DayuDIY/Xuanwu/玄武.jpg

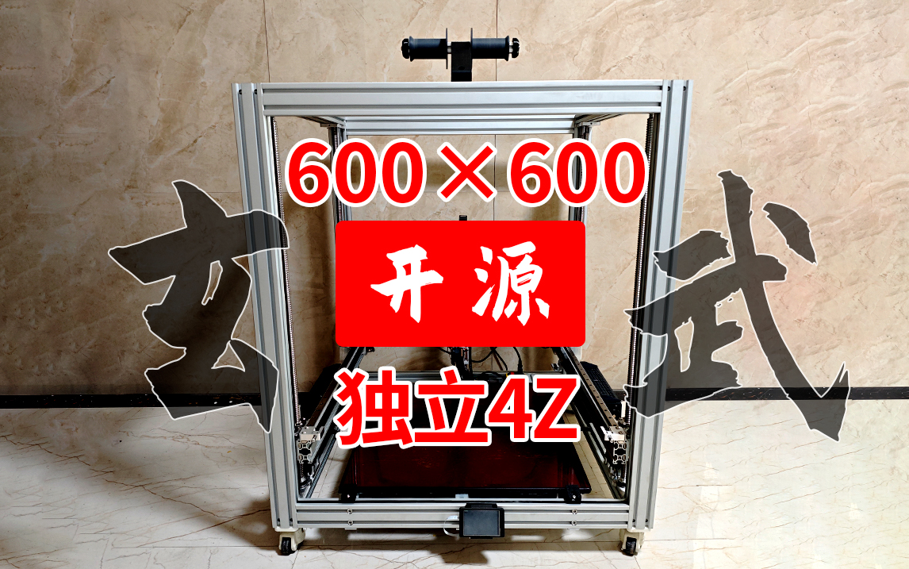
玄武.jpg
