DayuDIY/Xuanwu/README.md

# Xuanwu
来自中国的大鱼DIY开源的大型3D打印机项目，
你可以在哔哩哔哩上关注我，
以获取最新的资料及视频教程。
在哔哩哔哩上有该3D打印机的相关视频，
网址是：https://www.bilibili.com/video/BV1c6rmYjEGh/
该项目内容禁止商用！
