DayuDIY/Xuanwu/玄武_铝合金CNC零件/所有CNC零件.png

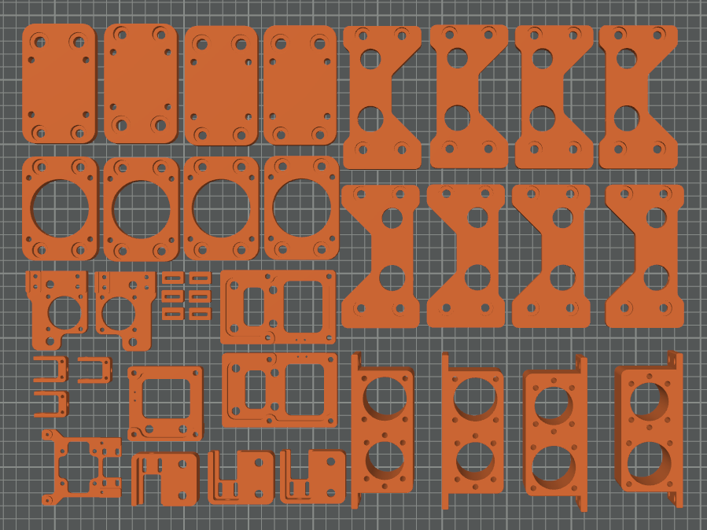
玄武_铝合金CNC零件/所有CNC零件.png
