DayuDIY/Xuanwu/B站【大鱼DIY】3D打印机_玄武 V1.0采购清单.xlsx

Sheet: 玄武1.0配件清单
【B站UP主：大鱼DIY】3D打印机_玄武 V1.0采购清单 以下所有链接本人未获取任何好处，若商家修改链接内容本人不承担任何后果，所有东西均可在淘宝找同规格产品，自己选择。
郑重声明 |  |  | 个别奸商篡改清单内容发到其他渠道，高价出售零部件的行为当真缺德，一经发现必定曝光！
视频教程 |  |  | https://www.bilibili.com/video/BV1c6rmYjEGh/
行程范围：600mm×600mm×600mm
序号 |  | 名称 | 规格 | 数量 | 单价 | 折扣/运费 | 总价 | 链接 | 备注
1 | Klipper 电气系统 FLY家的报我名字打9折 | 上位机+屏幕 | 套餐2 Fly Pi+3.5寸屏 | 1 | 199 | 0.9 | 179.1 | https://item.taobao.com/item.htm?_u=i208d75petd305&id=676114118467&skuId=5033614603650
 |  | 下位机 | SUPER 8 PRO | 1 | 288 | 0.9 | 259.2 | https://item.taobao.com/item.htm?spm=a1z10.5-c-s.w4002-23066022675.17.7d8a3903FVNXCO&id=677120565255
 |  | 大驱动 | TMC5160 Pro | 7 | 79 | 0.9 | 497.7 | https://item.taobao.com/item.htm?id=673666493168&skuId=5329371279692
 |  | 小驱动 | 2209 | 1 | 23 | 0.9 | 20.7 | https://item.taobao.com/item.htm?id=637412178454&skuId=5330446627699
 |  | 无线网卡 | 150M单频 迷你便携 | 1 | 19.8 | 0 | 19.8 | https://detail.tmall.com/item.htm?_u=i208d75petfee9&id=650379489910&spm=a1z09.2.0.0.4db42e8dCEay8S
 |  |  |  |  |  | 小计 | 976.5
2 | 非标结构件 | 非标CNC结构件 不含挤出机 |  | 1 | 1058 | 10 | 1068 | https://item.taobao.com/item.htm?id=872197698068&spm=a21xtw.29178619.product_shelf.1.30316a3cvkQzgr
 |  | klicky调平 |  | 1 | 20 | 10 | 30
 | 工具头 | 双丝进料工具头 含挤出机+热端+鸣志电机 | 报我名字有折扣 | 1 | 700 | 0.9 | 630 | https://item.taobao.com/item.htm?id=872770468601&spm=a213gs.v2success.0.0.1cd14831dNM7qx
 |  |  |  |  |  | 小计 | 1728
3 | 铝型材 两个链接，一个是嘉立创的，一个是淘宝的，选一个即可 | 欧标3060+3030铝型材 总共18根 | 参照图纸加工 图纸发送给卖家即可 | 1 | 700 | 60 | 760 | https://www.jlcfa.com/serial/1165480689116.html?codeModel=TXLF-308-W&productModel=TXLF-308-W
 |  |  |  | 两个价格一样，自由选择 |  |  |  | https://item.taobao.com/item.htm?id=557406833178&skuId=5706890393991
 | 选配型材 | 欧标2020铝型材 330mm长 用于安装料架，非必要 | 两头中心孔攻丝M6，共1根 | 1 | 8 | 0 | 8
 |  |  |  |  |  | 小计 | 768
4 | 线轨 | 线轨 报我名字打9折 | 670mm长轨道+ MGN15H滑块 | 3 | 81 | 0 | 243 | https://item.taobao.com/item.htm?id=538777574566&spm=2015.23436601.0.0&qq-pf-to=pcqq.c2c
 |  |  |  |  |  | 小计 | 243
5 | 光轴 | 光轴 | 硬轴直径20mm 858mm长 | 4 | 26.5 | 0 | 106 | https://item.taobao.com/item.htm?_u=t208d75pet2cd6&id=586921043351&sku_properties=122276018%3A20213
 | 法兰直线轴承 | 方型法兰轴承 | LMK20UU LMK20×32×42 | 4 | 8.5 | 0 | 34
 |  |  |  |  |  | 小计 | 140
6 | 滚珠丝杆 | 按图加工 858mm长4根 | 1605丝杆+螺母 | 4 | 95 | 0 | 380 | https://item.taobao.com/item.htm?_u=t208d75pet3a03&id=714103839586&spm=a1z09.2.0.0.3c722e8dJf2jAr
 |  |  |  |  |  | 小计 | 380
7 | 弹簧 | 用于XYZ三轴调节同步带松紧 | 线径1外径8长20 | 1 | 5 | 0 | 5 | https://detail.tmall.com/item.htm?_u=t208d75petf549&id=575363698316&spm=a1z09.2.0.0.3c722e8dJf2jAr
 |  | 用于压紧滚珠丝杆 | 线径1.4外径11长30 | 1 | 8 | 0 | 8
8 | 钢化玻璃 | 透明的便宜一点，55包邮 茶色及黑色贵一点 | 600mm*630mm 厚度8mm | 1 | 55 | 0 | 55 | https://detail.tmall.com/item.htm?_u=t208d75petad27&id=605517219162&spm=a1z09.2.0.0.3c722e8dJf2jAr
9 | T型硅胶条 | 卡在铝型材里面 作为热床的隔热和缓冲 | TP34 | 2 | 7 | 0 | 14 | https://detail.tmall.com/item.htm?_u=t208d75petcb68&id=733876404468&spm=a1z09.2.0.0.3c722e8dJf2jAr
10 | 硅胶热床 | 按图纸定制 出线放在距离边缘200mm处 | 600*600 | 1 | 180 | -20 | 160 | https://detail.tmall.com/item.htm?_u=t208d75pet4ef8&id=624594518317&spm=a1z09.2.0.0.3c722e8dJf2jAr
11 | 保温棉 | 自己裁剪 贴在硅胶加热垫下面 | 带背胶10mm厚1平米 | 1 | 4.3 | 0 | 4.3 | https://detail.tmall.com/item.htm?_u=t208d75pet43e7&id=694013872425&spm=a1z09.2.0.0.3c722e8dJf2jAr
12 | 福马轮 |  | 福马轮40F | 4 | 10 | 0 | 40 | https://item.taobao.com/item.htm?_u=t208d75petdd6a&id=614622055158&spm=a1z09.2.0.0.3c722e8dJf2jAr
 |  |  |  |  |  | 小计 | 286.3
13 | 【同志】3D打印机配件包 |  | 详见本表第二页 | 1 | 479.47 | -49.47 | 430 | https://item.taobao.com/item.htm?id=873787432434&spm=a213gs.v2success.0.0.259948315EvLyy
 |  |  |  |  |  | 小计 | 430
14 | 螺钉 螺母 | 单头铜柱 | M3×20+6 | 2 | 0.6 | 0 | 1.2 | https://detail.tmall.com/item.htm?id=541776094503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
15 |  | 内六角平圆头螺钉 | M3×6 | 30 | 0.03 | 0 | 0.9
16 |  |  | M3×12 | 56 | 0.04 | 0 | 2.24 | https://detail.tmall.com/item.htm?id=637014599330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
17
18 |  |  | M3×22 | 10 | 0.08 | 0 | 0.8
19 |  |  | M3×25 | 2 | 0.09 | 0 | 0.18
20 |  |  | M4×8 | 12 | 0.05 | 0 | 0.6
21 |  |  | M6×12 | 124 | 0.16 | 0 | 19.84
22 |  |  | M6×20 | 3 | 0.18 | 0 | 0.54
23 |  |  | M8×16 | 28 | 0.22 | 0 | 6.16
24 |  | 内六角圆柱头螺钉 | M2×10 | 18 | 0.03 | 0 | 0.54 | https://detail.tmall.com/item.htm?_u=4208d75pet5977&id=601878243485&skuId=5535412599027
25 |  |  | M3×8 | 50 | 0.03 | 0 | 1.5
26 |  |  | M5×16 | 40 | 0.14 | 0 | 5.6
27 |  |  | M5×30 | 15 | 0.2 | 0 | 3
28 |  |  | M5×35 | 16 | 0.22 | 0 | 3.52
29 |  |  | M8×35 | 12 | 0.65 | 0 | 7.8
30 |  |  | M8×65 | 16 | 0.94 | 0 | 15.04
31 |  | 垫片 | 8×12×1 | 8 | 0.07 | 0 | 0.56 | https://detail.tmall.com/item.htm?abbucket=16&id=601878075662
32 |  |  | 5×12×1 | 3 | 0.05 | 0 | 0.15
33 |  | T型螺母 | 20型M3 仅用于固定料架 | 2 | 0.1 | 0 | 0.2 | https://item.taobao.com/item.htm?_u=4208d75petb3ab&id=15146235453&spm=a1z09.2.0.0.4e072e8dACxZCR
34 |  |  | 30型M3×15.5×8 | 64 | 0.1 | 0 | 6.4
35 |  | 滑块螺母，需要提前放入型材 用T型螺母更省事，不用提前放好 | 30型M6-A | 124 | 0.1 | 0 | 12.4 | https://item.taobao.com/item.htm?_u=4208d75petdcd7&id=41966325030&skuId=5098531407012
36 |  | 弹形扣件 | 欧标3030（50个） 只需要16个 | 1 | 7.8 | 0 | 7.8 | https://detail.tmall.com/item.htm?_u=4208d75petacd2&id=710086294864&spm=a1z09.2.0.0.28112e8dzYkcnE
37 |  | 外螺纹圆柱销 | M5×20（5个） 需要7个 | 2 | 2.68 | 0 | 5.36 | https://detail.tmall.com/item.htm?_u=4208d75petdc6b&id=616664551961&spm=a1z09.2.0.0.28112e8dzYkcnE
39 |  | 热熔螺母 | M2×4×3.5 | 14 | 0.07 | 0 | 0.98 | https://detail.tmall.com/item.htm?_u=4208d75pet5769&id=691362839974&spm=a1z09.2.0.0.4e072e8dACxZCR
40 |  |  | M3×4×4.2 | 8 | 0.08 | 0 | 0.64
 |  |  |  |  |  | 小计 | 103.95
41 | 供电系统 | 明纬开关电源 | LRS-350-24 24V14.6A | 3 | 106 | 0 | 318 | https://item.taobao.com/item.htm?_u=i208d75pet6955&id=570951343107&spm=a1z09.2.0.0.4db42e8dCEay8S
42 |  | 电源插座 | 螺丝固定式-上下耳-大红开-带线 | 1 | 7.2 | 0 | 7.2 | https://detail.tmall.com/item.htm?_u=4208d75pet4cf3&id=795022264448&spm=a1z09.2.0.0.35282e8dAyc3v2
 |  |  |  |  |  | 小计 | 325.2
43 | 其他配件 | 横流风机 辅助散热用 | 40250D 24V | 2 | 75.8 | 0 | 151.6 | https://item.taobao.com/item.htm?_u=t208d75petecd3&id=524874916615&spm=a1z09.2.0.0.3c722e8dJf2jAr
44 |  | 一字连接板 | 3030型2孔 | 6 | 1.3 | 4 | 11.8 | https://item.taobao.com/item.htm?_u=t208d75peta1ec&id=533716881777&spm=a1z09.2.0.0.3c722e8dJf2jAr
 |  |  |  |  |  | 小计 | 163.4
 | 其他材料 | ① 1平方的线若干，用于品字开关分三路接开关电源的零线、火线和地线，以及开关电源的24V输出到主板和驱动，需要3个颜色，每个颜色约5米； ② 2平方的线若干，用于交流热床的供电； ③ 0.5平方的红黑双色线若干，用于延长加热棒的接线，每个颜色约4米； ④ 0.2平方的线若干，用于加长各种各样的线； ⑤ 热缩管若干，用于线路接头处的绝缘； ⑥ 缠绕管若干，用于收纳线束。
 |  |  |  |  |  | 合计: | 5544.35 | 如有遗漏或错误，麻烦您联系我更正，谢谢（不提供技术支持）！ QQ：88910246

Sheet: 【同志】3D打印机配件清单
序号 | 名称 | 规格 | 数量 | 单价 | 运费 | 小计 | 链接 | 货号
1 | 57步进电机 XYZ轴用 | 56高 1个3米长的线 2个2米长的线 | 3 | 56 | 0 | 168 | https://item.taobao.com/item.htm?id=796381580261&skuId=5432413033655
2 |  | 45高 1米线 | 4 | 46 | 0 | 184
3 | 同步轮 | 20齿内孔8带宽10 | 7 | 1.66 | 0 | 11.62 | https://item.taobao.com/item.htm?spm=a21dvs.23580594.0.0.1d293d0dSrcL9j&ft=t&id=559194333476
4 |  | 40齿内孔8带宽10 | 4 | 3.8 | 0 | 15.2
5 | 惰轮 | 20齿内孔5 带宽10带齿 | 3 | 1 | 0 | 3 | https://item.taobao.com/item.htm?id=559682437946&skuId=3872290557040
6 | 闭环同步带 | 带宽10mm周长220mm | 4 | 2.3 | 0 | 9.2 | https://item.taobao.com/item.htm?id=652223908476&spm=a1z10.3-c-s.w4002-17331600343.19.36f33e69KNJAi3
7 | 同步带 | GT2-10mm 10米/条 | 1 | 33.7 | 0 | 33.7 | https://item.taobao.com/item.htm?id=660458877911&skuId=4935925462805
8 | 限位开关 只接两根线 | 需要常闭，线长2米 | 3 | 1.3 | 0 | 3.9 | https://item.taobao.com/item.htm?spm=a21dvs.23580594.0.0.1d293d0dPgRrtF&ft=t&id=560056223373
9 | 铁氟龙管 引导线束用，非必要 | 乳白色2*4，1.75耗材 | 1 | 3.5 | 0 | 3.5 | https://item.taobao.com/item.htm?spm=a21dvs.23580594.0.0.1d293d0dPgRrtF&ft=t&id=659862681620
10 | 3010风扇 | 24V | 1 | 3 | 0 | 3 | https://item.taobao.com/item.htm?spm=a21dvs.23580594.0.0.1d293d0doZMbnz&ft=t&id=560285123186
11 | 4020鼓风风扇 | 24V两线 XH2.54 | 1 | 4.1 | 0 | 4.1 | https://item.taobao.com/item.htm?spm=a21dvs.23580594.0.0.1d293d0dPgRrtF&ft=t&id=560037644826
12 | 4010风扇 驱动散热 | 4010风扇12V | 7 | 1.85 | 0 | 12.95 | https://item.taobao.com/item.htm?id=559773126423&skuId=5097069995514
13 | 电源线 |  | 1 | 4.5 | 0 | 4.5 | https://item.taobao.com/item.htm?spm=a1z10.5-c-s.w4002-22254585059.16.16b33708kxrQvS&id=546606733627
14 | 法兰轴承 | F688ZZ（8*18*5） | 8 | 0.75 | 0 | 6 | https://item.taobao.com/item.htm?id=559716049401
15 | 隔离柱 | 5*10*15 | 12 | 0.6 | 0 | 7.2 | https://item.taobao.com/item.htm?id=620496119636
16 |  | 5*10*20 | 16 | 0.6 | 0 | 9.6
 |  |  |  |  | 合计 | 479.47
