DayuDIY/Xuanwu/玄武_3D打印零件/4020风道.3mf

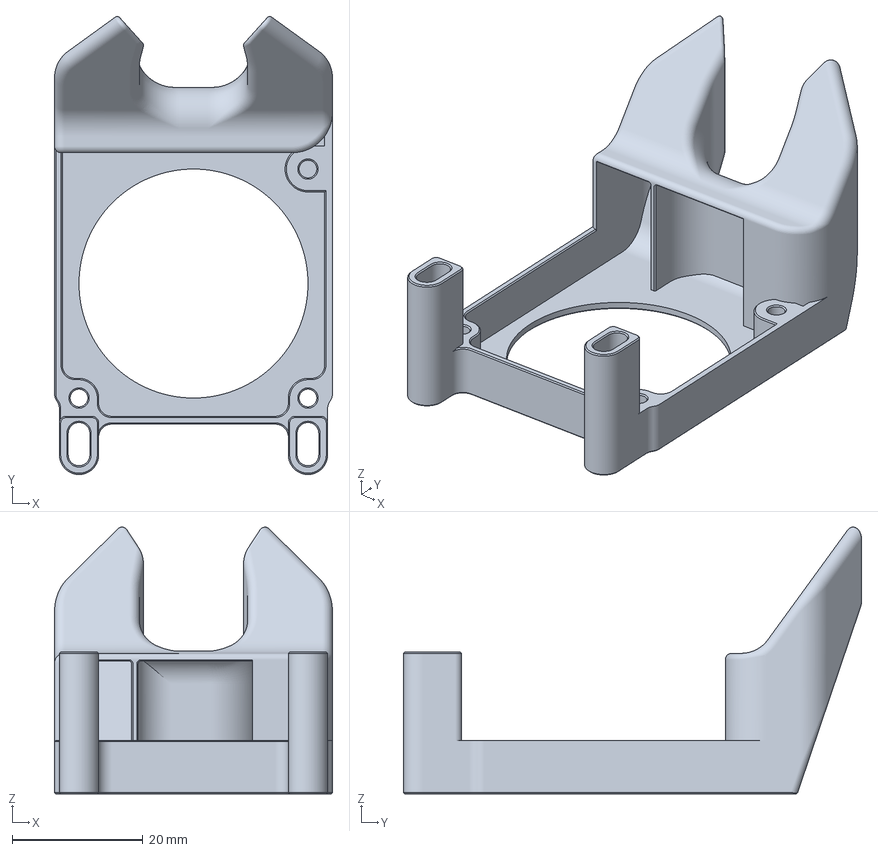
[picture p3: CAD file, 2025-01-11]
玄武_3D打印零件/4020风道.3mf
42.5 x 70.0 x 40.8 mm
