DayuDIY/Xuanwu/玄武_3D打印零件/可自行打印零件/料架组件_适用于常见的1~3公斤耗材/料架_玄武.STEP

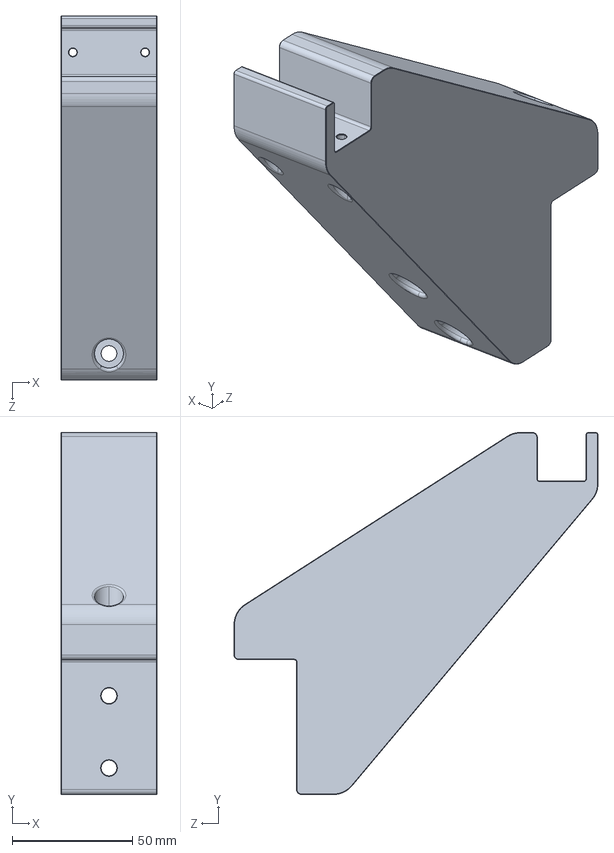
[picture p4: CAD file, 2025-01-11]
玄武_3D打印零件/可自行打印零件/料架组件_适用于常见的1~3公斤耗材/料架_玄武.STEP
40.0 x 150.4 x 151.2 mm
