DayuDIY/Xuanwu/玄武_3D打印零件/可自行打印零件/电气仓零件/屏幕组件_FLY TFT/屏幕盖子_FLY TFT V2.STEP

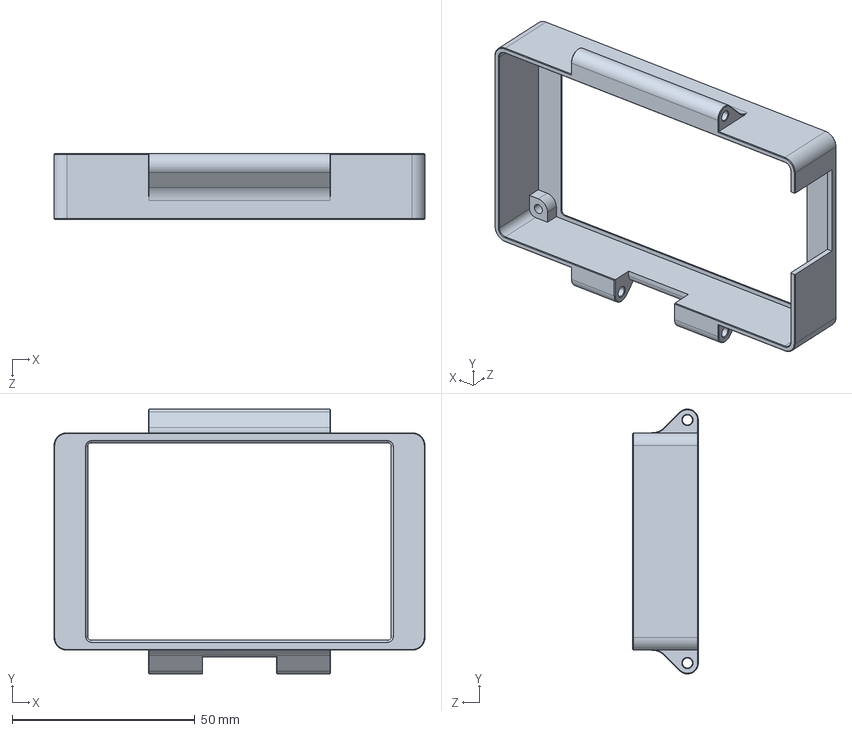
[picture p5: CAD file, 2025-01-11]
玄武_3D打印零件/可自行打印零件/电气仓零件/屏幕组件_FLY TFT/屏幕盖子_FLY TFT V2.STEP
101.5 x 72.5 x 18.0 mm
