DayuDIY/Xuanwu/玄武_3D打印零件/可自行打印零件/辅助风扇组件_2套/40贯流风扇防护网.STEP

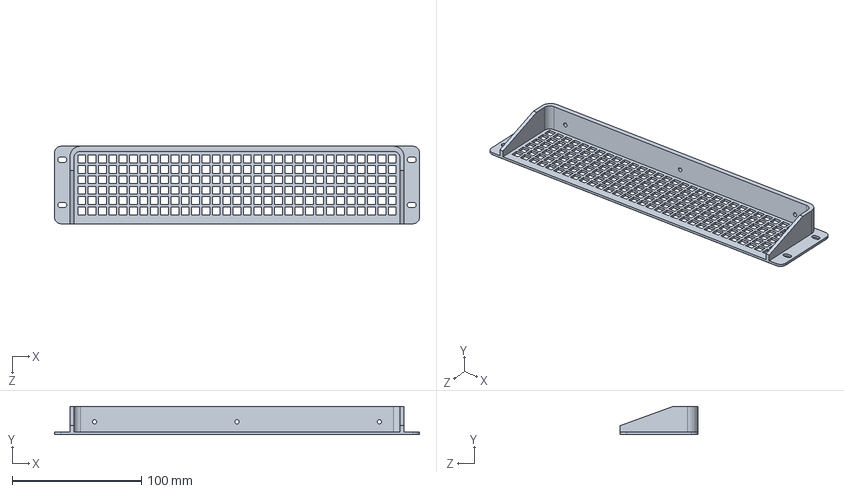
[picture p7: CAD file, 2025-01-11]
玄武_3D打印零件/可自行打印零件/辅助风扇组件_2套/40贯流风扇防护网.STEP
282.0 x 22.0 x 60.0 mm
