DayuDIY/Xuanwu/玄武_3D打印零件/装机必备打印件/Klicky组件/klicky安装座.STEP

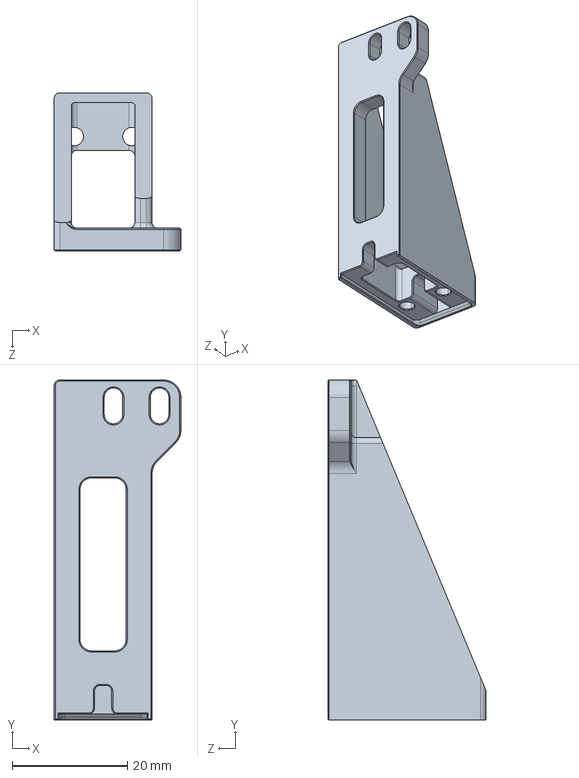
[picture p8: CAD file, 2025-01-11]
玄武_3D打印零件/装机必备打印件/Klicky组件/klicky安装座.STEP
22.0 x 59.0 x 27.5 mm
