DayuDIY/Xuanwu/玄武_铝合金CNC零件/STP格式/57步进电机支架_Z轴_4件.STEP

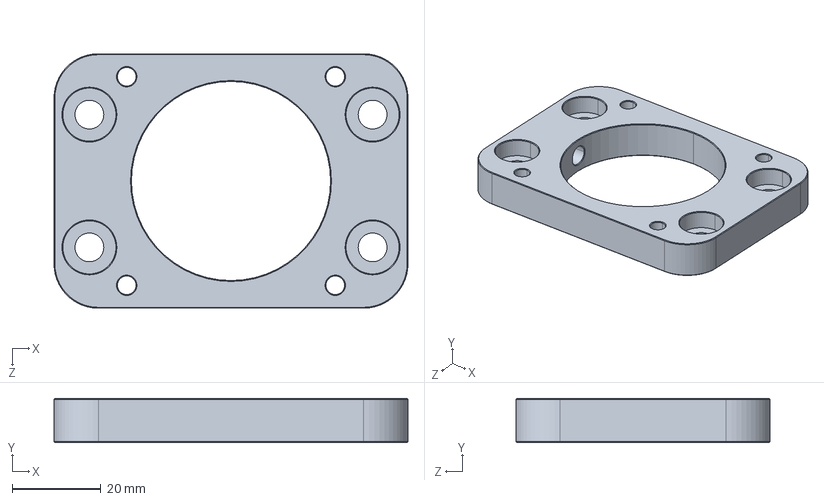
[picture p9: CAD file, 2025-01-11]
玄武_铝合金CNC零件/STP格式/57步进电机支架_Z轴_4件.STEP
80.0 x 10.0 x 57.5 mm
