DayuDIY/Xuanwu/玄武_3D打印零件/可自行打印零件/料架组件_适用于常见的1~3公斤耗材/滚筒堵头_2件.STEP

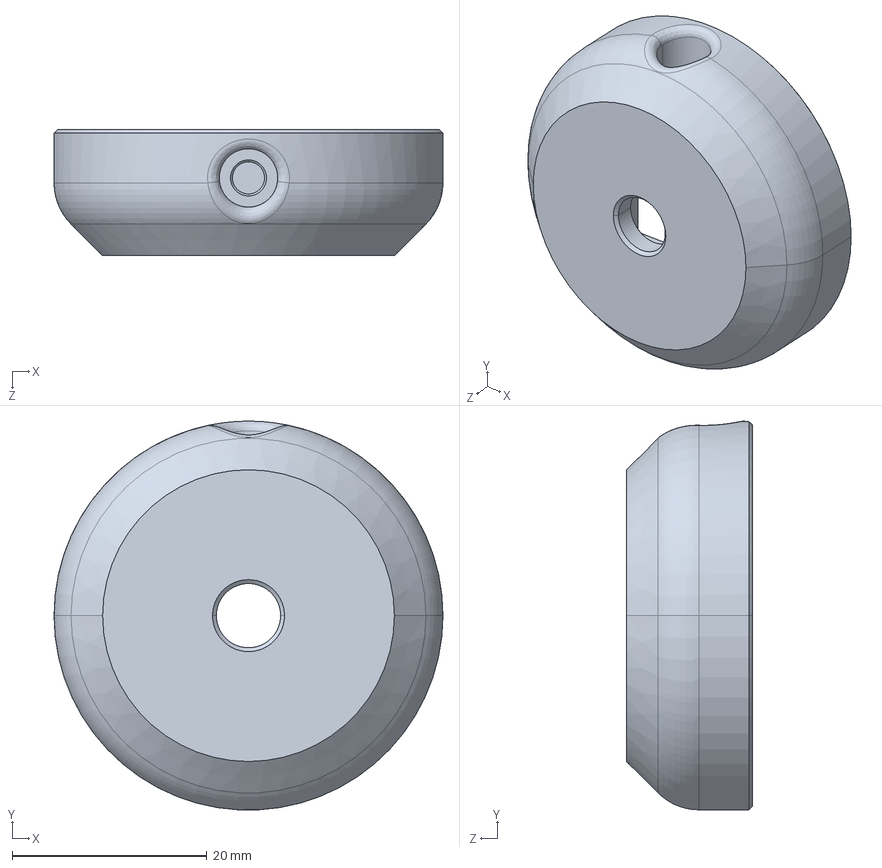
[picture p10: CAD file, 2025-01-11]
玄武_3D打印零件/可自行打印零件/料架组件_适用于常见的1~3公斤耗材/滚筒堵头_2件.STEP
40.0 x 40.0 x 13.0 mm
