DayuDIY/Xuanwu/玄武_3D打印零件/可自行打印零件/电气仓零件/屏幕组件_FLY TFT/调节臂.STEP

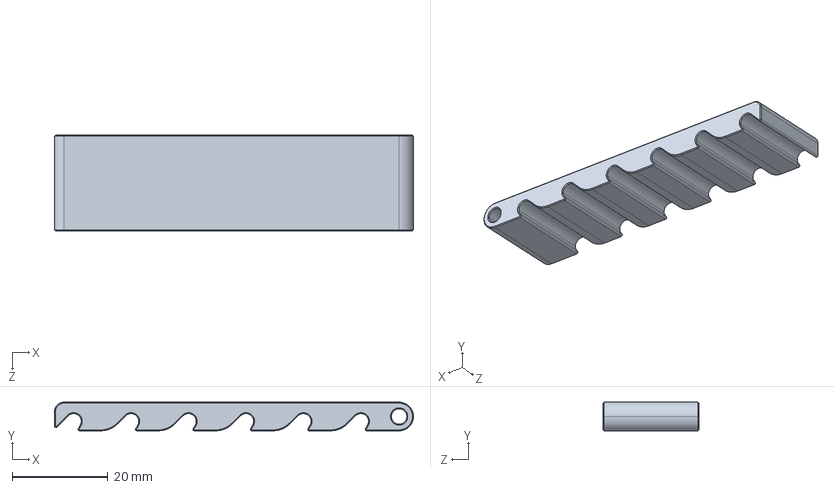
[picture p11: CAD file, 2025-01-11]
玄武_3D打印零件/可自行打印零件/电气仓零件/屏幕组件_FLY TFT/调节臂.STEP
75.0 x 6.00 x 20.0 mm
