DayuDIY/Xuanwu/玄武_3D打印零件/可自行打印零件/电气仓零件/电源锁紧卡扣.STEP

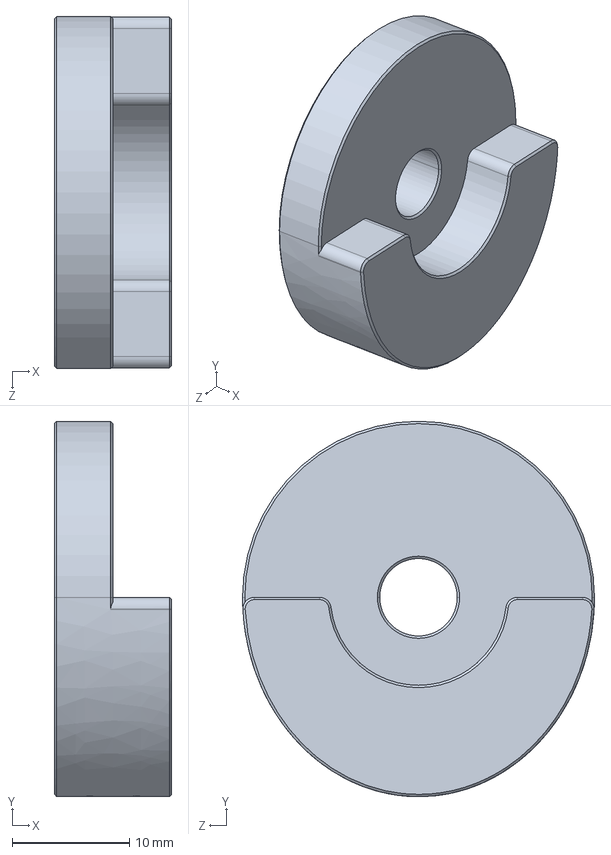
[picture p12: CAD file, 2025-01-11]
玄武_3D打印零件/可自行打印零件/电气仓零件/电源锁紧卡扣.STEP
10.0 x 32.0 x 30.0 mm
