DayuDIY/Xuanwu/玄武_3D打印零件/可自行打印零件/辅助风扇组件_2套/40贯流风扇安装支架.STEP

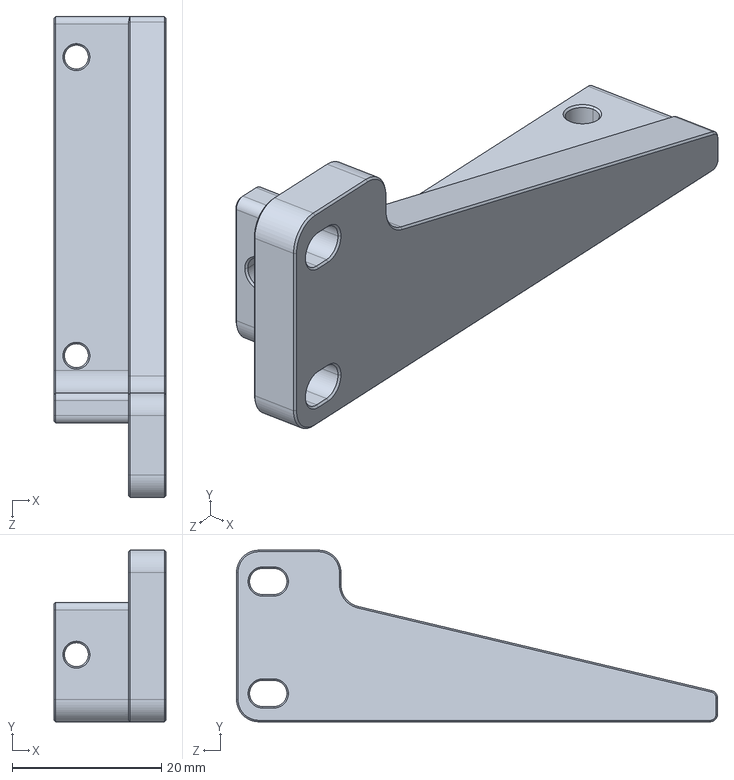
[picture p13: CAD file, 2025-01-11]
玄武_3D打印零件/可自行打印零件/辅助风扇组件_2套/40贯流风扇安装支架.STEP
15.0 x 23.0 x 64.4 mm
