DayuDIY/Xuanwu/玄武_3D打印零件/装机必备打印件/Klicky组件/klicky停靠坞.STEP

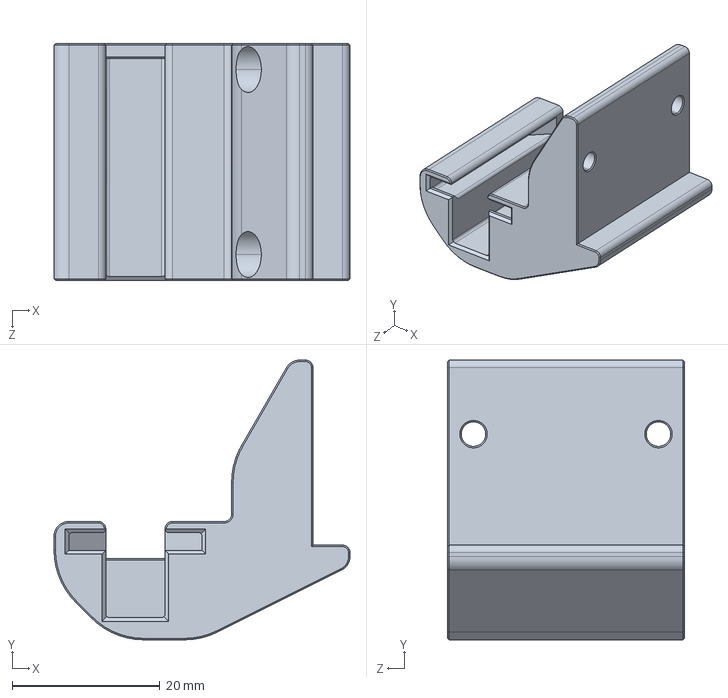
[picture p14: CAD file, 2025-01-11]
玄武_3D打印零件/装机必备打印件/Klicky组件/klicky停靠坞.STEP
40.0 x 37.8 x 32.0 mm
