DayuDIY/Xuanwu/玄武_3D打印零件/装机必备打印件/喉管风扇支架.STEP

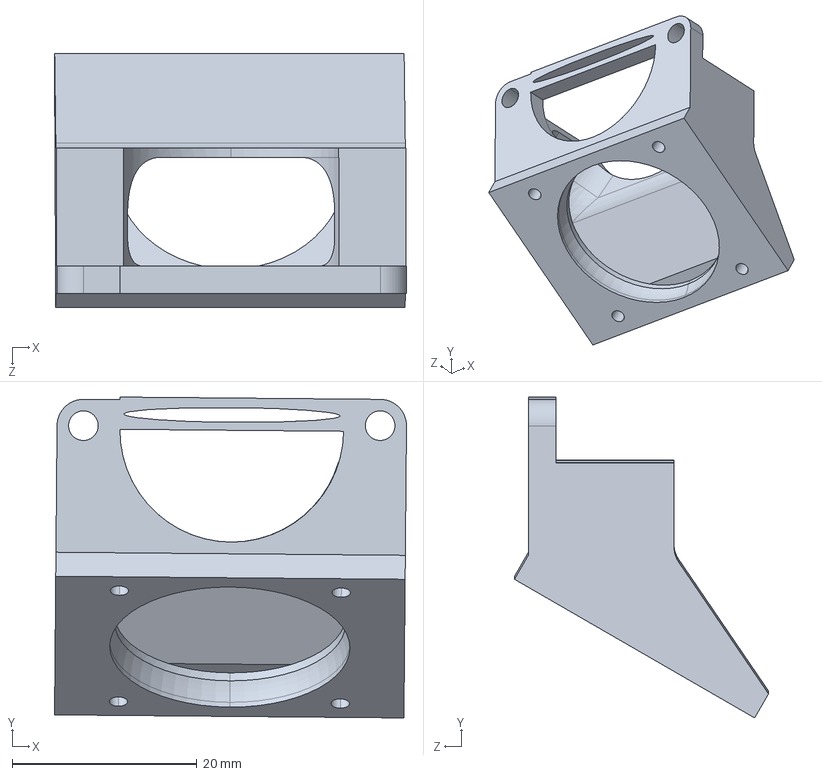
[picture p15: CAD file, 2025-01-11]
玄武_3D打印零件/装机必备打印件/喉管风扇支架.STEP
38.1 x 34.7 x 27.5 mm
