DayuDIY/Xuanwu/玄武_铝合金CNC零件/STP格式/X轴转接件_双进丝.STEP

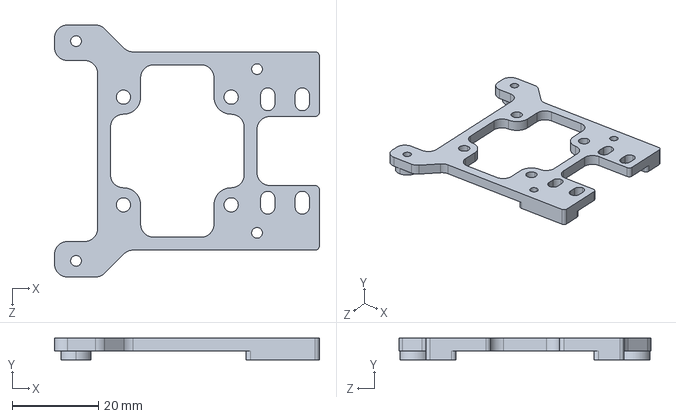
[picture p16: CAD file, 2025-01-11]
玄武_铝合金CNC零件/STP格式/X轴转接件_双进丝.STEP
61.5 x 5.00 x 58.5 mm
