DayuDIY/Xuanwu/玄武_3D打印零件/可自行打印零件/料架组件_适用于常见的1~3公斤耗材/耗材滚筒_2件.STEP

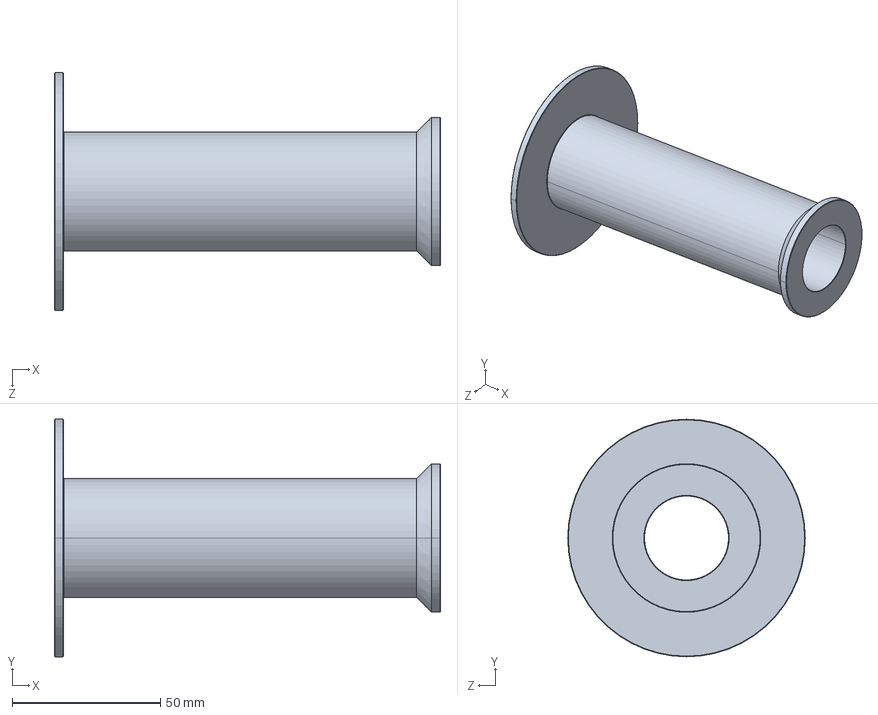
[picture p17: CAD file, 2025-01-11]
玄武_3D打印零件/可自行打印零件/料架组件_适用于常见的1~3公斤耗材/耗材滚筒_2件.STEP
130.0 x 80.0 x 80.0 mm
