DayuDIY/Xuanwu/玄武_3D打印零件/可自行打印零件/电气仓零件/屏幕组件_FLY TFT/屏幕底板.STEP

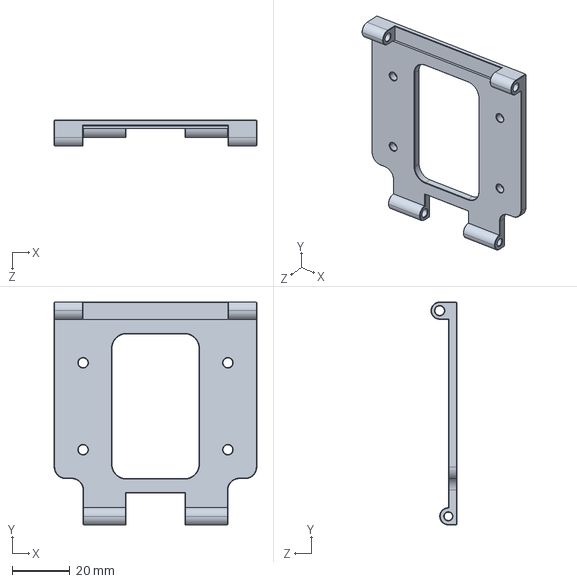
[picture p18: CAD file, 2025-01-11]
玄武_3D打印零件/可自行打印零件/电气仓零件/屏幕组件_FLY TFT/屏幕底板.STEP
70.0 x 77.0 x 9.00 mm
