DayuDIY/Xuanwu/玄武_3D打印零件/可自行打印零件/电气仓零件/电气仓底板_FLY V1.1.STEP

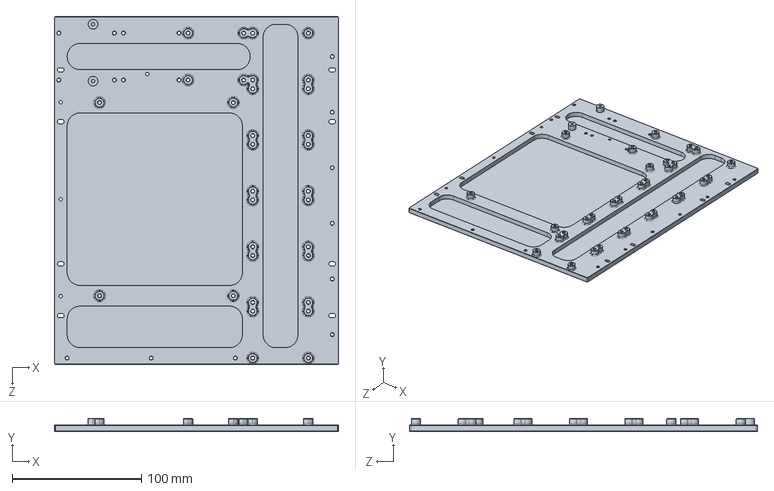
[picture p19: CAD file, 2025-01-11]
玄武_3D打印零件/可自行打印零件/电气仓零件/电气仓底板_FLY V1.1.STEP
220.0 x 10.0 x 269.2 mm
