DayuDIY/Xuanwu/玄武_3D打印零件/可自行打印零件/辅助风扇组件_2套/40贯流风扇风道.STEP

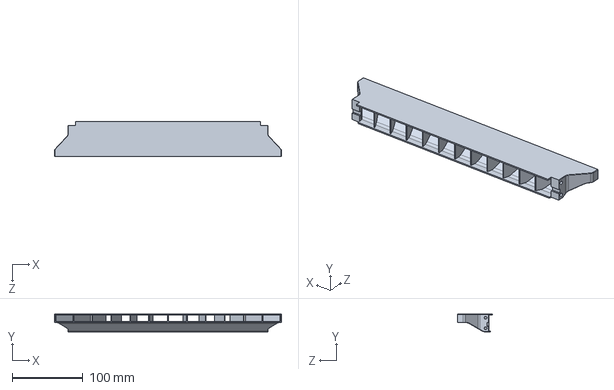
[picture p20: CAD file, 2025-01-11]
玄武_3D打印零件/可自行打印零件/辅助风扇组件_2套/40贯流风扇风道.STEP
320.0 x 25.0 x 50.0 mm
