DayuDIY/Xuanwu/玄武_3D打印零件/装机必备打印件/热床压紧块_4件.STEP

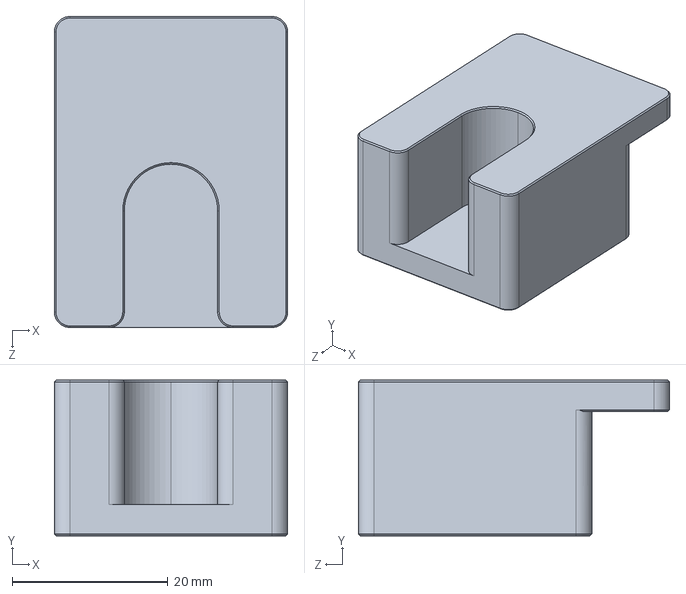
[picture p21: CAD file, 2025-01-11]
玄武_3D打印零件/装机必备打印件/热床压紧块_4件.STEP
30.0 x 20.0 x 40.0 mm
