DayuDIY/Xuanwu/玄武_铝合金CNC零件/STP格式/直线轴承座_上_2件.STEP

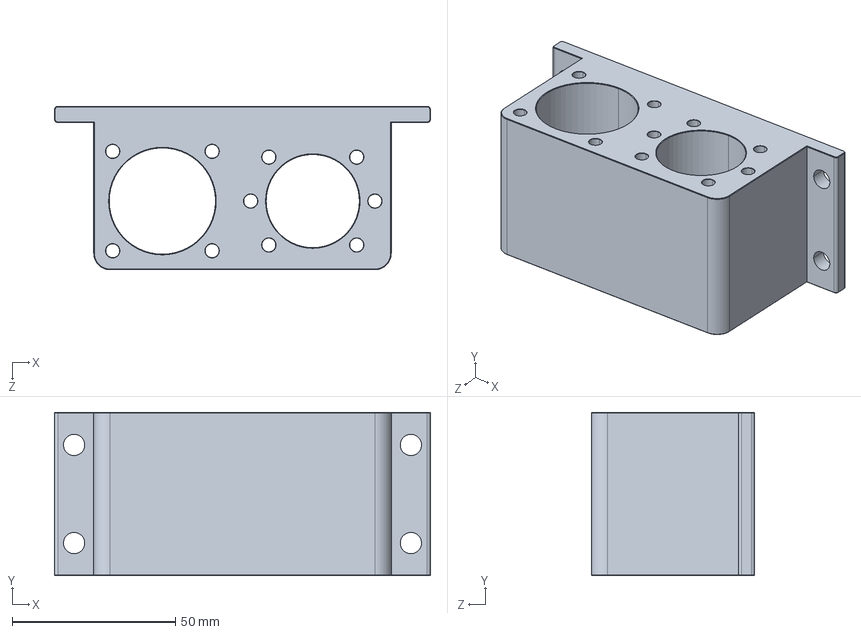
[picture p22: CAD file, 2025-01-11]
玄武_铝合金CNC零件/STP格式/直线轴承座_上_2件.STEP
115.0 x 50.0 x 50.0 mm
