DayuDIY/Xuanwu/玄武_3D打印零件/可自行打印零件/料架组件_适用于常见的1~3公斤耗材/顶置料架_装配图.STEP

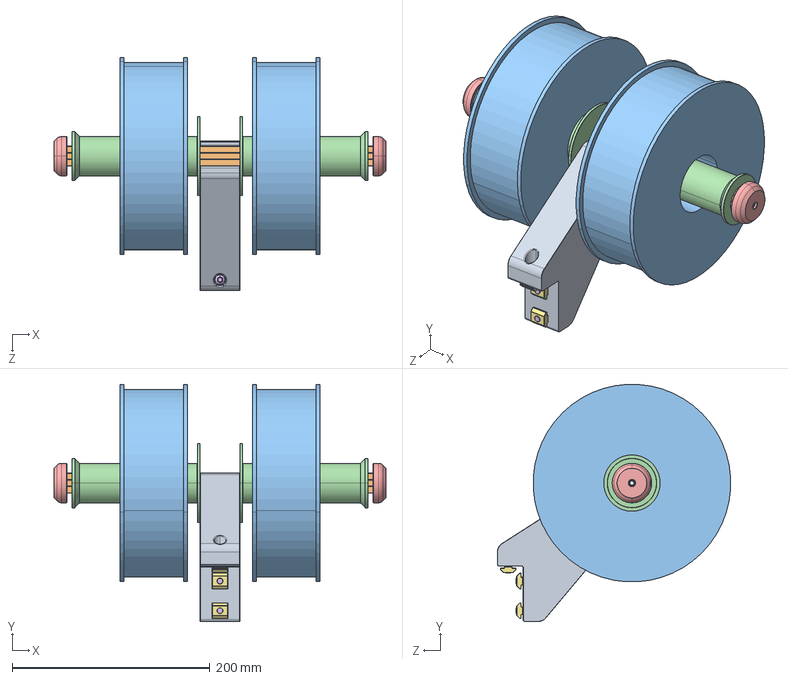
[picture p23: CAD file, 2025-01-11]
玄武_3D打印零件/可自行打印零件/料架组件_适用于常见的1~3公斤耗材/顶置料架_装配图.STEP
336.0 x 240.0 x 236.0 mm
料架_玄武
铝型材2020料架
耗材 x 2
耗材滚筒 x 2
滚筒堵头 x 2
内六角平圆头螺钉M6×12 x 3
滑块螺母_欧标30型M6_A x 3
