DayuDIY/Xuanwu/玄武_3D打印零件/可自行打印零件/电气仓零件/电源连接件.STEP

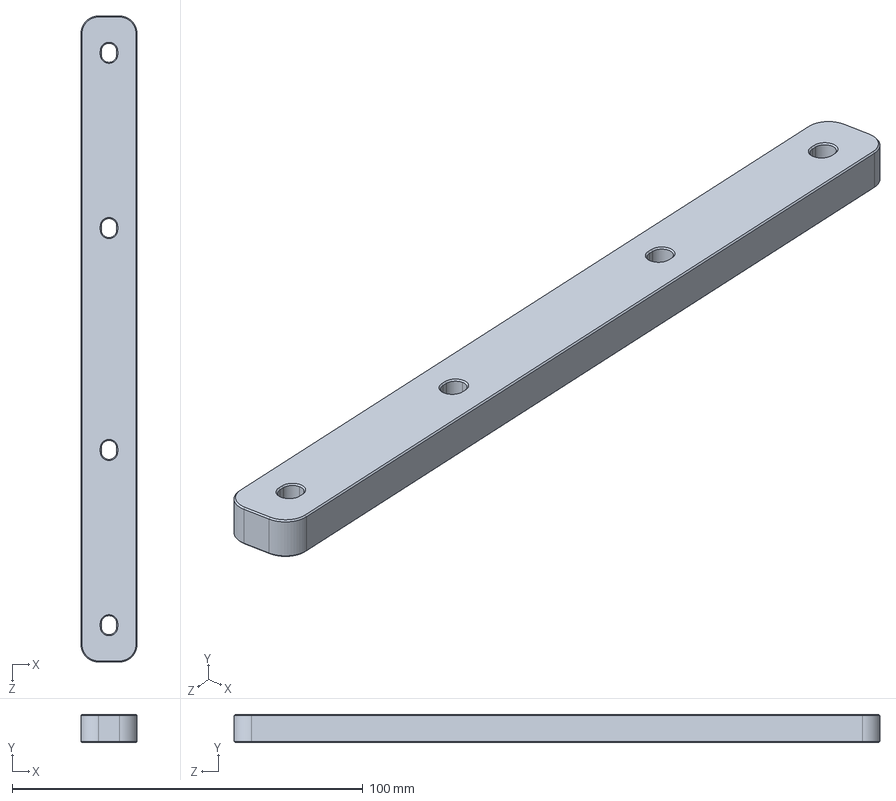
[picture p24: CAD file, 2025-01-11]
玄武_3D打印零件/可自行打印零件/电气仓零件/电源连接件.STEP
16.0 x 8.00 x 184.3 mm
