DayuDIY/Xuanwu/玄武_铝合金CNC零件/STP格式/同步带卡扣_6件.STEP

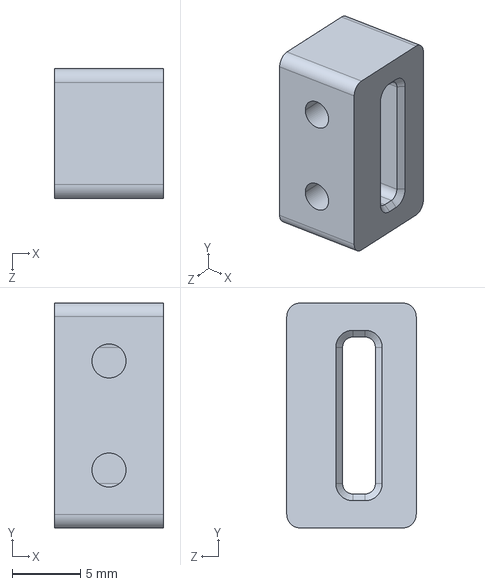
[picture p25: CAD file, 2025-01-11]
玄武_铝合金CNC零件/STP格式/同步带卡扣_6件.STEP
8.00 x 16.5 x 9.50 mm
