DayuDIY/Xuanwu/玄武_3D打印零件/可自行打印零件/电气仓零件/上位机托架_FLY PI.STEP

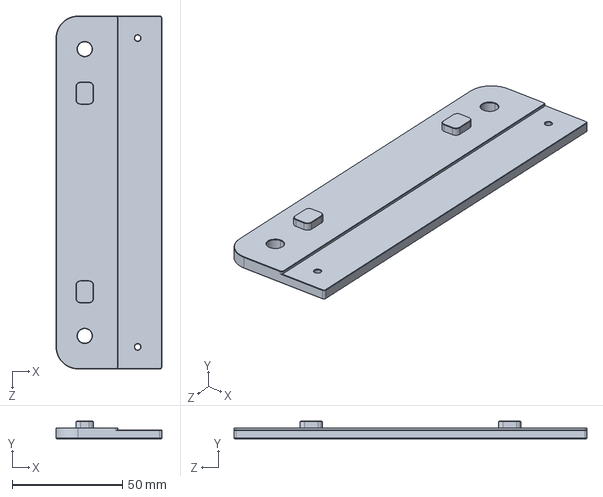
[picture p26: CAD file, 2025-01-11]
玄武_3D打印零件/可自行打印零件/电气仓零件/上位机托架_FLY PI.STEP
48.0 x 8.00 x 160.0 mm
