DayuDIY/Xuanwu/玄武_3D打印零件/可自行打印零件/电气仓零件/品字开关安装座.STEP

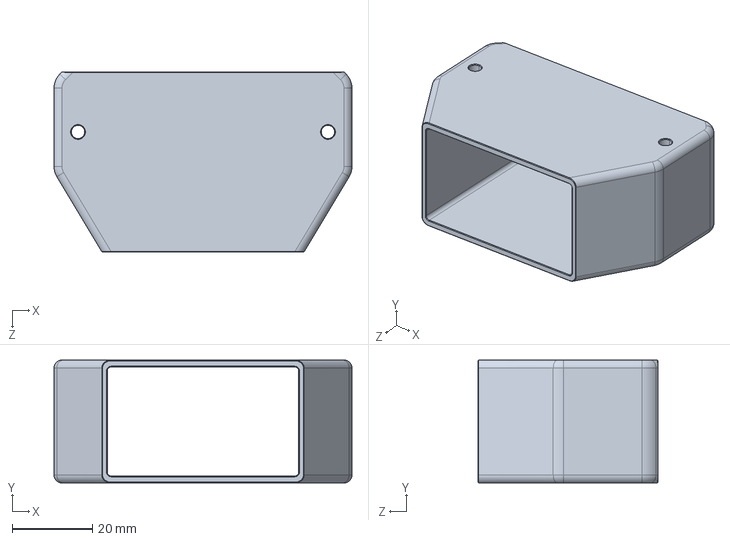
[picture p28: CAD file, 2025-01-11]
玄武_3D打印零件/可自行打印零件/电气仓零件/品字开关安装座.STEP
74.4 x 30.7 x 45.0 mm
