DayuDIY/Xuanwu/玄武_铝合金CNC零件/STP格式/光轴座_Z1_4件.STEP

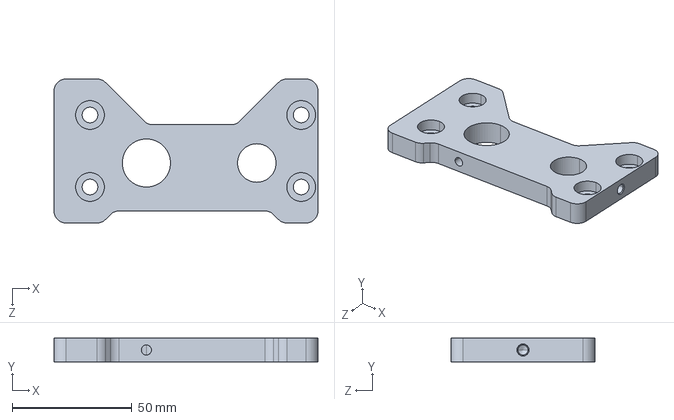
[picture p29: CAD file, 2025-01-11]
玄武_铝合金CNC零件/STP格式/光轴座_Z1_4件.STEP
110.0 x 10.0 x 60.0 mm
