DayuDIY/Xuanwu/玄武_3D打印零件/可自行打印零件/电气仓零件/上位机及开关电源固定底板.STEP

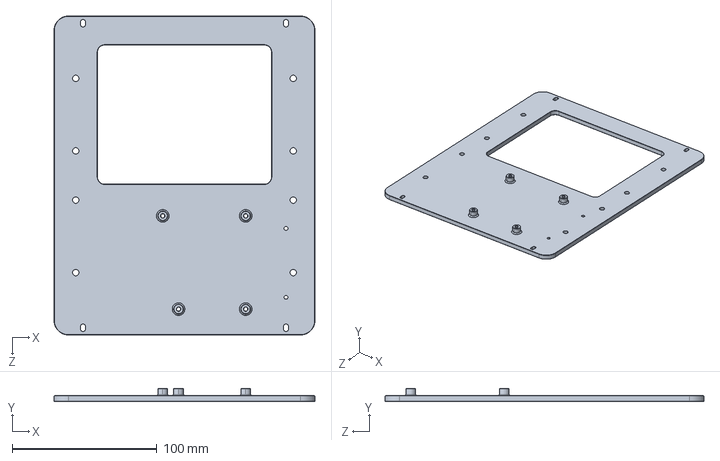
[picture p30: CAD file, 2025-01-11]
玄武_3D打印零件/可自行打印零件/电气仓零件/上位机及开关电源固定底板.STEP
180.0 x 9.00 x 220.0 mm
