DayuDIY/Xuanwu/玄武_3D打印零件/可自行打印零件/电气仓零件/下位机托架_Super 8 Pro.STEP

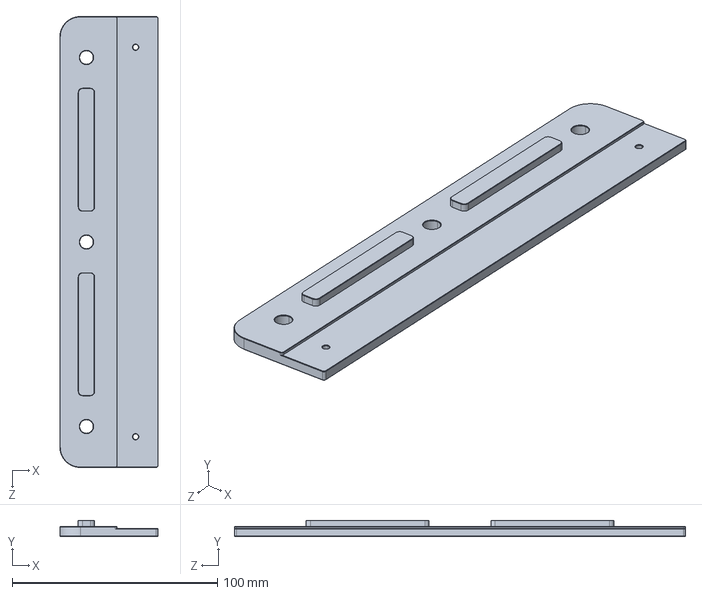
[picture p31: CAD file, 2025-01-11]
玄武_3D打印零件/可自行打印零件/电气仓零件/下位机托架_Super 8 Pro.STEP
48.0 x 8.00 x 220.0 mm
