DayuDIY/Xuanwu/玄武_铝合金CNC零件/STP格式/57步进电机支架_Y轴_右.STEP

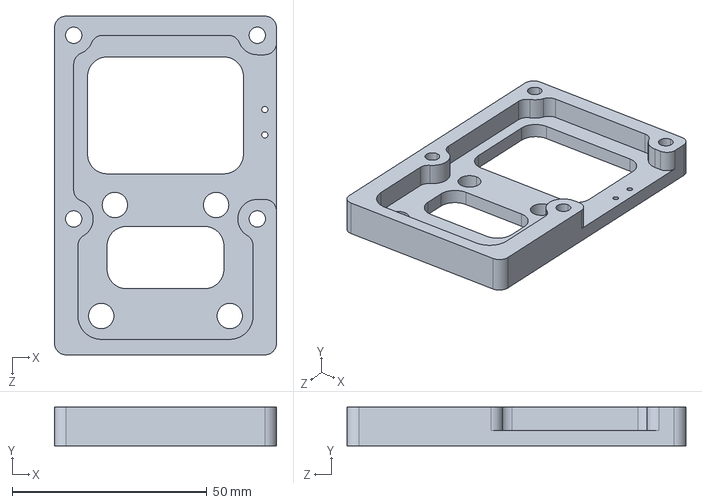
[picture p32: CAD file, 2025-01-11]
玄武_铝合金CNC零件/STP格式/57步进电机支架_Y轴_右.STEP
57.0 x 10.0 x 87.0 mm
