DayuDIY/Xuanwu/玄武_铝合金CNC零件/STP格式/惰轮支架_3件.STEP

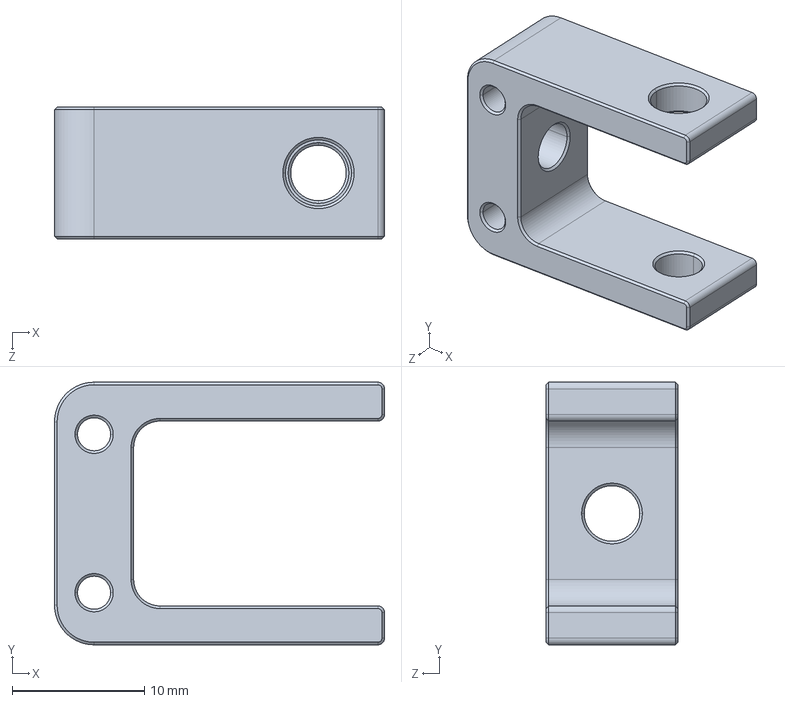
[picture p33: CAD file, 2025-01-11]
玄武_铝合金CNC零件/STP格式/惰轮支架_3件.STEP
25.0 x 19.9 x 10.0 mm
