DayuDIY/Xuanwu/玄武_铝合金CNC零件/STP格式/57步进电机支架_X轴.STEP

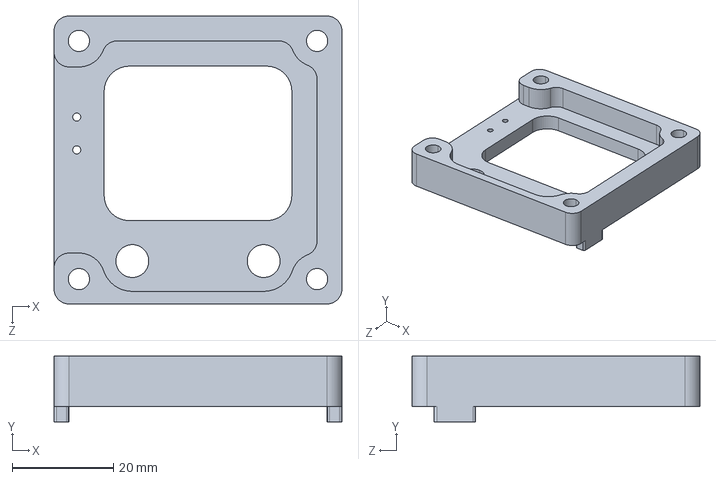
[picture p34: CAD file, 2025-01-11]
玄武_铝合金CNC零件/STP格式/57步进电机支架_X轴.STEP
57.0 x 13.0 x 57.0 mm
