DayuDIY/Xuanwu/玄武_铝合金CNC零件/STP格式/福马轮40F_转接板_4件.STEP

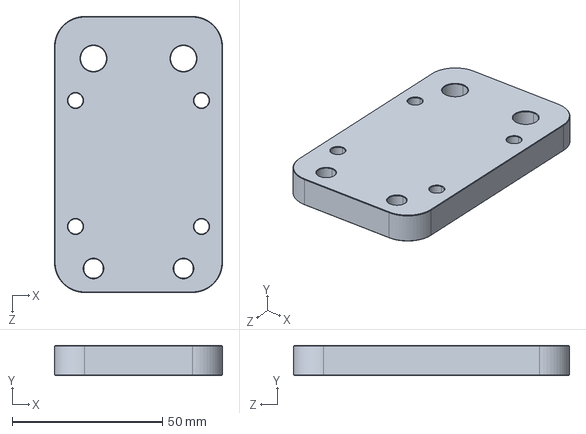
[picture p35: CAD file, 2025-01-11]
玄武_铝合金CNC零件/STP格式/福马轮40F_转接板_4件.STEP
56.0 x 10.0 x 92.0 mm
