DayuDIY/Xuanwu/玄武_铝合金CNC零件/STP格式/惰轮调节底座_左_2件.STEP

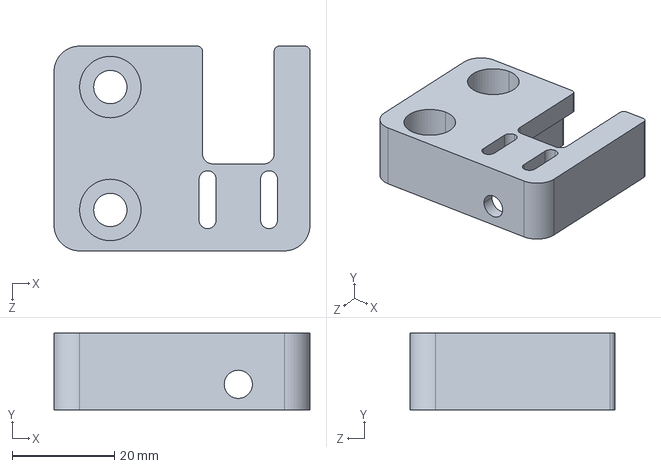
[picture p36: CAD file, 2025-01-11]
玄武_铝合金CNC零件/STP格式/惰轮调节底座_左_2件.STEP
50.0 x 15.0 x 40.0 mm
