DayuDIY/Xuanwu/玄武_铝合金CNC零件/STP格式/Y轴转接件_左.STEP

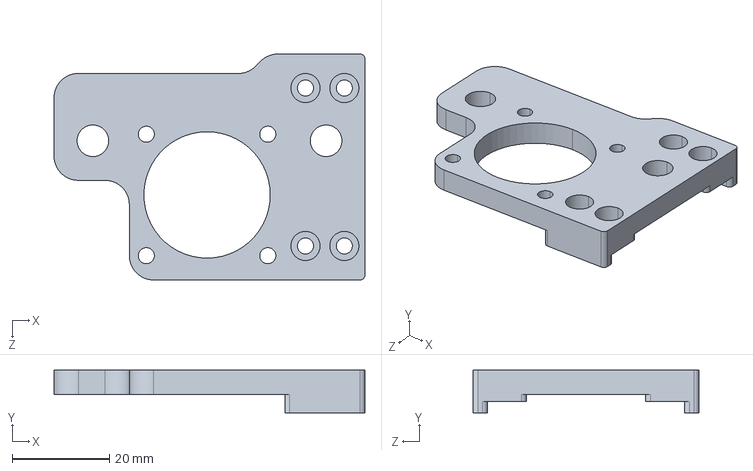
[picture p37: CAD file, 2025-01-11]
玄武_铝合金CNC零件/STP格式/Y轴转接件_左.STEP
64.0 x 8.80 x 46.5 mm
