DayuDIY/Xuanwu/(list of files, cad)

Other CAD files:
玄武_3D打印零件/装机必备打印件/4020风道.STEP
玄武_铝合金CNC零件/STP格式/57步进电机支架_Y轴_左.STEP
玄武_铝合金CNC零件/STP格式/光轴座_Z2_4件.STEP
玄武_铝合金CNC零件/STP格式/惰轮调节底座_右.STEP
