DayuDIY/Xuanwu/1605滚珠丝杆.pdf

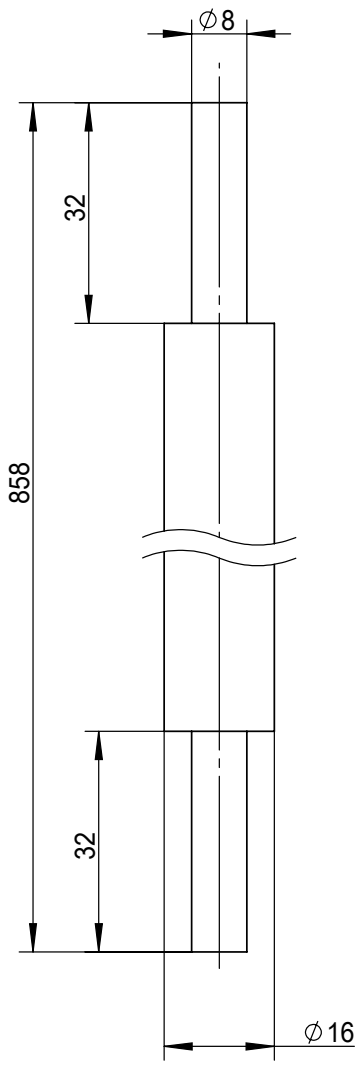
[picture p38: page 1]
