DayuDIY/Xuanwu/玄武_硅胶加热垫图纸/玄武_硅胶加热垫图纸.pdf

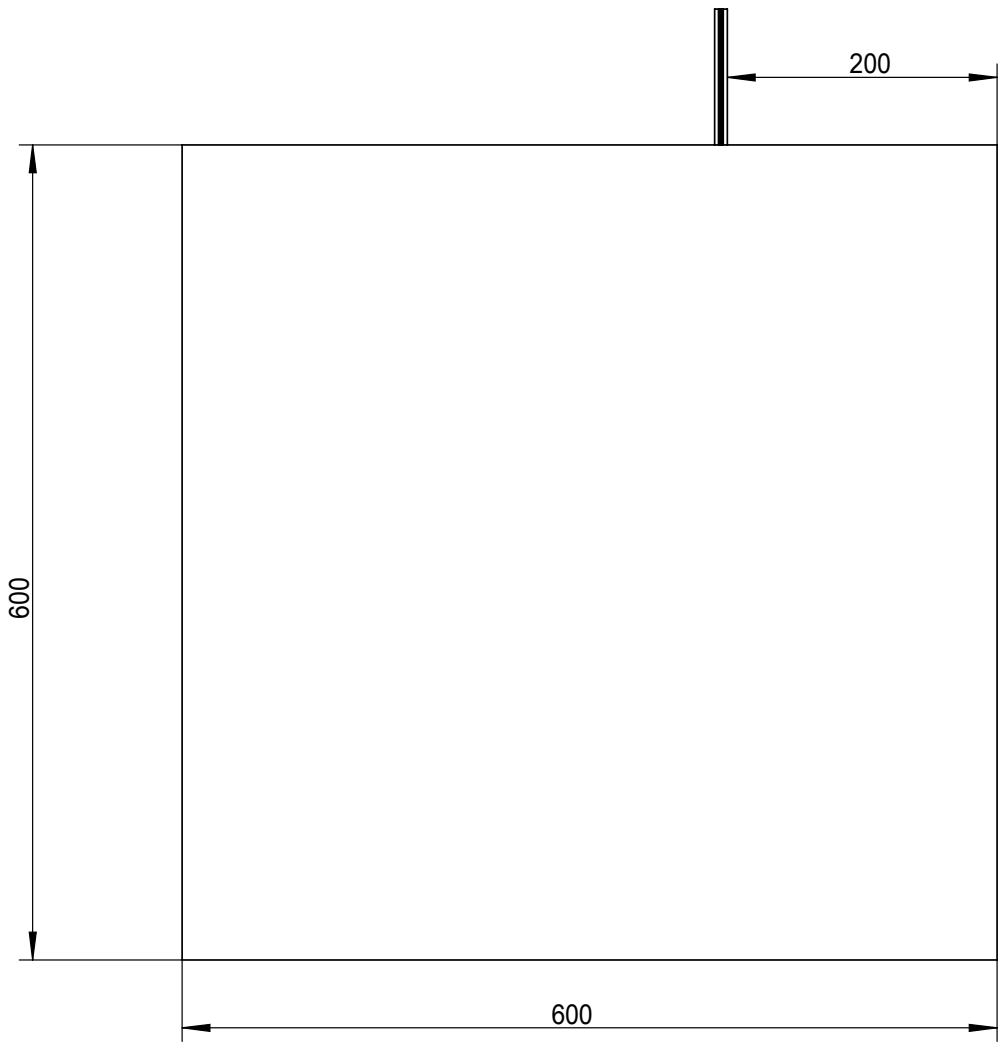
[picture p39: page 1]
