DayuDIY/Xuanwu/玄武_铝型材加工图纸/玄武1.0_铝型材加工图纸.pdf

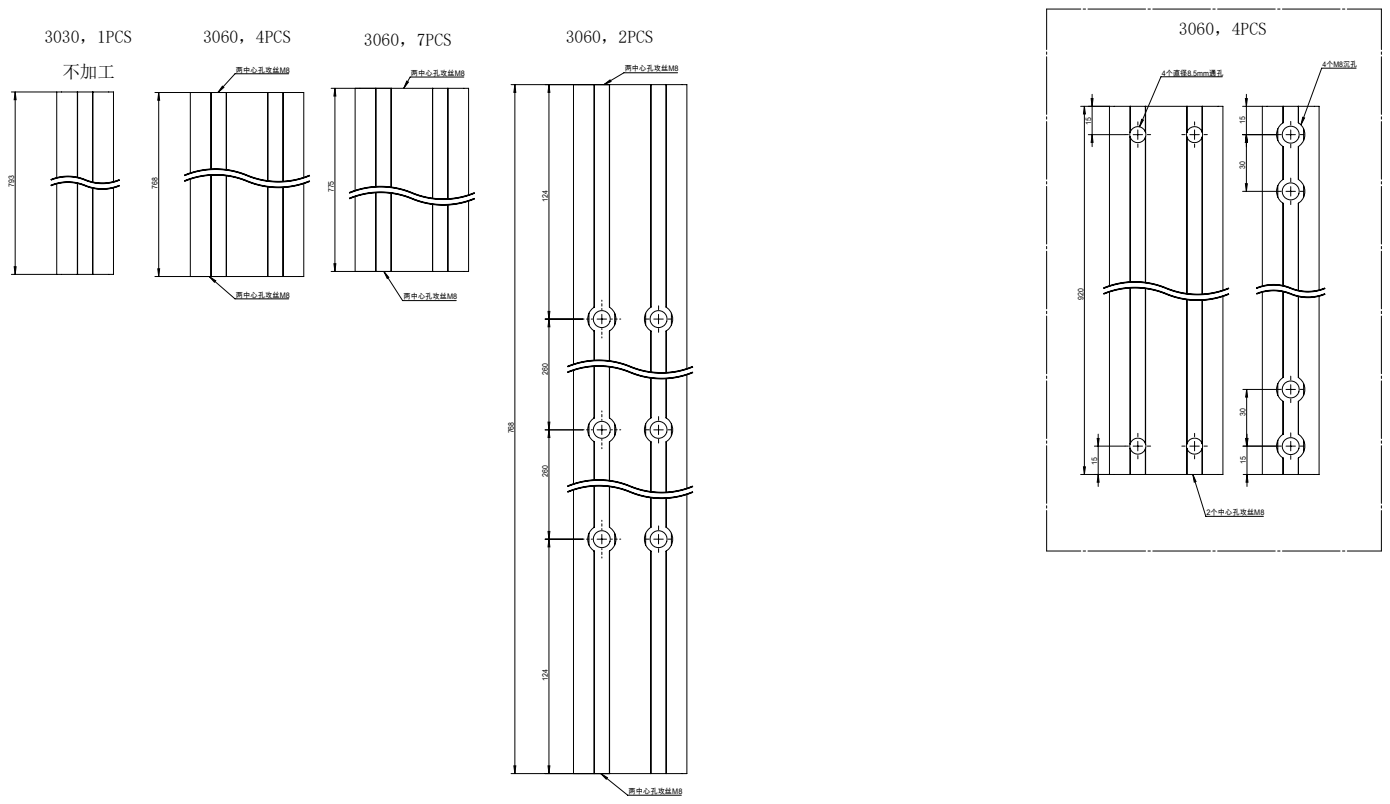
[picture p40: page 1]
3060，4PCS; 3060，7PCS; 3060，4PCS 3060，2PCS
