DayuDIY/Xuanwu/玄武_固件配置及Orca切片参数/固件配置/玄武_printer.cfg

####################################################################################
#                         3D MELLOW /FLY-Super8-Pro                                #
####################################################################################
## FLY-Super8-Pro 资料网址： http://mellow.klipper.cn/#/board/fly_super8_pro/README
## FLY-Super8-Pro 原理图网址：https://github.com/Mellow-3D/Fly-Super8Pro
## FLY 官方淘宝店：https://shop126791347.taobao.com/shop/view_shop.htm?spm=a230r.1.14.4.1a4840a8hyvpPJ&user_number_id=2464680006
## 如需售后，请联系淘宝客服
## FLY 售后技术支持群：621032883
## FLY-RRF固件交流群：786561979

#####################################################################
#                               注意事项                               #
#####################################################################
##***需要更改/检查的事项：***
## MCU 路径                              [mcu] 
## 打印机活动范围                           xyz的position      
## 热敏电阻类型                             [extruder] 和 [heater_bed]
## Z轴限位开关停止位置                      [homing_override] 
## Z轴限位开关偏移位置                      [stepper_z] 
## PID 校准                               [extruder] 和 [heater_bed] 
## 微调挤出机电机步进值                     [extruder] 

#####################################################################
#                               文件调用                               #
#####################################################################
[include fluidd.cfg]          # FLUIDD调用文件。
#[include mainsail.cfg]        # MAINSDIL调用文件。
[include klicky-probe.cfg]    #调用klicky-probe文件
#需要自行确定使用哪个文件

#####################################################################
#                               主板配置                               #
#####################################################################

[mcu]                           # FLY主板ID
serial:/dev/serial/by-id/usb-Klipper_stm32h723xx_29003D000551313430323835-if00
### 查询usb固件id是：ls -l /dev/serial/by-id/
### 把/dev/serial/by-id/usb-Klipper_stm32f407xx_XXXXXXXXXXXXXXXXXXXXX替换查询到的id
#canbus_uuid: e51d5c71a901
### 查询can固件id是：~/klippy-env/bin/python ~/klipper/scripts/canbus_query.py can0
### can的id需要把serial替换成canbus_uuid: 后面添加id 

#####################################################################
#                            机型和加速度                            #
#####################################################################
[printer]                       # 打印机设置
kinematics: cartesian           # 运动学结构分为：笛卡尔和corexy等等。笛卡尔：cartesian
max_velocity: 300               # 打印机最大速度   
max_accel: 30000                # 最大加速度 最大3000
max_z_velocity: 10              # z轴最大速度
max_z_accel: 100                # z轴最大加速度
square_corner_velocity: 5.0     # 方形拐角速度，小一点可以有效避免平台重带来的惯性

#[mcu adxl]
#serial: /dev/serial/by-id/usb-Klipper_rp2040_E66250758B075A26-if00
### 查询usb固件id是：ls -l /dev/serial/by-id/
### 把/dev/serial/by-id/usb-Klipper_rp2040_XXXXXXXXXXXXXXXXXXXXX替换查询到的id

##ADXL345加速度计
#[adxl345]
#cs_pin: adxl:gpio9
#spi_software_sclk_pin: adxl:gpio10
#spi_software_mosi_pin: adxl:gpio11
#spi_software_miso_pin: adxl:gpio12

#[resonance_tester]
#accel_chip: adxl345
#probe_points:
#    300, 300, 20  # 此坐标为你需要测量的位置，一般为热床中间

#####################################################################
#                             共振补偿                               #
#####################################################################
[input_shaper]
shaper_freq_x:76.8  # frequency for the X mark of the test model
shaper_type_x: mzv
shaper_freq_y:80  # frequency for the Y mark of the test model
shaper_type_x: 3hump_ei
#####################################################################
#                             温度监控                               #
#####################################################################
[temperature_sensor Fly-Super8]     # FLY主板温度（可自行重命名）
sensor_type: temperature_mcu     # 关联mcu（默认）
min_temp: 0                      # 最小温度（注意：测量温度超过设定值会触发紧急停止）
max_temp: 200                    # 最大温度（注意：测量温度超过设定值会触发紧急停止）
#--------------------------------------------------------------------
[temperature_sensor FLY-π]        # 上位机温度
sensor_type: temperature_host     # 关联上位机
min_temp: 0                       # 最小温度（注意：测量温度超过设定值会触发紧急停止）
max_temp: 200                     # 最大温度（注意：测量温度超过设定值会触发紧急停止）
#--------------------------------------------------------------------
# [temperature_sensor Box]          # 箱内温度温度 （需要增加一颗温感,参考配置）
# sensor_type: ATC Semitec 104GT-2  # 传感器型号
# sensor_pin: PA4                   # 信号接口
# min_temp: 0                       # 最小温度（注意：测量温度超过设定值会触发紧急停止）
# max_temp: 490                     # 最大温度（注意：测量温度超过设定值会触发紧急停止）

#####################################################################
#                              热床网格校准
#####################################################################
[bed_mesh]
speed: 50                    # 校准速度
horizontal_move_z: 5         # 探针前往下一个点之前Z需要抬升的高
mesh_min: 50,50              # 最小校准点坐标x，y
mesh_max: 550, 550           # 最大校准点坐标x，y
probe_count: 6,6             # 采样点数（4X4为16点）
mesh_pps: 2,2                # 补充采样点数
algorithm: bicubic           # 算法模型
bicubic_tension: 0.2         # 算法插值不要动

#####################################################################
#             X/Y步进电机设置 (X/Y Stepper Settings)                 # 
#####################################################################
#   Y Motor ---- Motor Y1 
#   |                  |
#   |------挤出机-------|
#   |                  |
#   |                  |
#          正前方   
#####################################################################
#                  X 轴步进电机 on Driver0                  #
#####################################################################
[stepper_x]
step_pin: PE6                       # X轴电机脉冲引脚设置
dir_pin: !PG6                       # X轴电机运行引脚设置,方向按实际判断，加感叹号会让运行方向反转
enable_pin: !PG7                   # X轴电机使能引脚设置,使能引脚需要加感叹号，否者电机不工作
rotation_distance: 40               # 主动带轮周长mm（2GT-20T带轮40，2GT-16T带轮32）
microsteps: 16                      # 电机细分设置，细分越高，质量越高，但主控负荷越大
full_steps_per_rotation: 200        # 电机单圈所需脉冲数（1.8度电机:200，0.9度电机:400）
endstop_pin: PG12                   # 限位开关PIN脚,建议常闭然后添加！反转状态,位置在io-0
###接常闭后是触发状态，加感叹号可以反转这个状态，万一断线时候可以避免撞机
position_min: 0                     # 软限位最小行程
position_endstop: 0                 # 软限位最大行程 (600mm)
position_max: 610                   # 机械限位最大行程 (600mm)
homing_speed: 50                    # 复位速度，最大为100.归位速度建议别太快
homing_retract_dist: 5              # 第一次触发复位开关之后的后退距离
homing_positive_dir: false           # 复位方向（一般不需要改动）
step_pulse_duration: 0.000004
#--------------------------------------------------------------------
##  请确保驱动型号配置正确 (2208 or 2209)
#[tmc2209 stepper_x]                 # X 驱动配置 -TMC2209
#uart_pin: PC4                       # 通讯端口Pin脚定义
#interpolate: False                  # 是否开启256微步插值（开启是True，关闭是False）
#run_current: 0.8                    # 电机运行电流值（单位：mA）
#sense_resistor: 0.110               # 驱动采样电阻不要改
#stealthchop_threshold: 500          # 静音阀值（如果不需要静音，请将数值改为0）
#--------------------------------------------------------------------
[tmc5160 stepper_x]                 # X 驱动配置- TMC5160
cs_pin: PG5   
#spi_bus:spi1a
spi_software_mosi_pin: PB5
spi_software_miso_pin: PB4
spi_software_sclk_pin: PB3
run_current: 1.0                    # 电机运行电流值
interpolate: True                  # 是否开启256微步插值（开启是True，关闭是False）
sense_resistor: 0.033               # 驱动采样电阻不要改（如果使用5160 Pro，请将数值修改为0.033）
stealthchop_threshold: 0          # 静音阀值（如果不需要静音，请将数值改为0）

#####################################################################
#                  Y 轴步进电机 on Driver1                 #
#####################################################################
[stepper_y]
step_pin: PE0                       # Y轴电机脉冲引脚设置
dir_pin: PG3                      # Y轴电机运行引脚设置,方向按实际判断，加感叹号会让运行方向反转
enable_pin: !PG4                   # Y轴电机使能引脚设置,使能引脚需要加感叹号，否者电机不工作
rotation_distance: 40               # 主动带轮周长mm（2GT-20T带轮40，2GT-16T带轮32）
microsteps: 16                      # 电机细分设置，细分越高，质量越高，但主控负荷越大
full_steps_per_rotation: 200        # 电机单圈所需脉冲数（1.8度电机:200，0.9度电机:400）
endstop_pin: PG11                  # 限位开关PIN脚,建议常闭然后添加！反转状态,位置在io-1
###接常闭后是触发状态，加感叹号可以反转这个状态，万一断线时候可以避免撞机
position_min: 0                     # 软限位最小行程
position_endstop: 600               # 软限位最大行程 (250mm-300mm-350mm)
position_max: 600                   # 机械限位最大行程 (250mm-300mm-350mm)
homing_speed: 50                    # 复位速度，最大为100        归位速度建议别太快
homing_retract_dist: 5              # 第一次触发复位开关之后的后退距离
homing_positive_dir: true           # 复位方向（一般不需要改动）
step_pulse_duration: 0.000004
#--------------------------------------------------------------------
##  请确保驱动型号配置正确 (2208 or 2209)
#[tmc2209 stepper_y]                 # Y驱动配置 -TMC2209
#uart_pin: PF12                      # 通讯端口Pin脚定义
#interpolate: False                  # 是否开启256微步插值（开启是True，关闭是False）
#run_current: 0.8                    # 电机运行电流值（单位：mA）
#sense_resistor: 0.110               # 驱动采样电阻不要改
#stealthchop_threshold: 500          # 静音阀值（如果不需要静音，请将数值改为0）
#--------------------------------------------------------------------
[tmc5160 stepper_y]                 # 挤出机驱动配置- TMC5160
cs_pin: PG2                        # SPI 片选Pin脚定义
spi_software_mosi_pin: PB5
spi_software_miso_pin: PB4
spi_software_sclk_pin: PB3
run_current: 2                    # 电机运行电流值
interpolate: True                  # 是否开启256微步插值（开启是True，关闭是False）
sense_resistor: 0.033               # 驱动采样电阻不要改（如果使用5160 Pro，请将数值修改为0.033）
stealthchop_threshold: 0          # 静音阀值（如果不需要静音，请将数值改为0）

#####################################################################
#                  Y1 轴步进电机 on Driver3                 #
#####################################################################
[stepper_y1]
step_pin: PE1                       # Y轴电机脉冲引脚设置
dir_pin: !PF0                      # Y轴电机运行引脚设置,方向按实际判断，加感叹号会让运行方向反转
enable_pin: !PC15                   # Y轴电机使能引脚设置,使能引脚需要加感叹号，否者电机不工作
rotation_distance: 40               # 主动带轮周长mm（2GT-20T带轮40，2GT-16T带轮32）
microsteps: 16                      # 电机细分设置，细分越高，质量越高，但主控负荷越大
full_steps_per_rotation: 200        # 电机单圈所需脉冲数（1.8度电机:200，0.9度电机:400）
endstop_pin: PG10                  # 限位开关PIN脚,建议常闭然后添加！反转状态,位置在io-0
###接常闭后是触发状态，加感叹号可以反转这个状态，万一断线时候可以避免撞机
#position_min: 0                     # 软限位最小行程
#position_endstop: 600               # 软限位最大行程 (250mm-300mm-350mm)
#position_max: 600                   # 机械限位最大行程 (250mm-300mm-350mm)
#homing_speed: 50                    # 复位速度，最大为100        归位速度建议别太快
#homing_retract_dist: 5              # 第一次触发复位开关之后的后退距离
#homing_positive_dir: true           # 复位方向（一般不需要改动）
step_pulse_duration: 0.000004
#--------------------------------------------------------------------
[tmc5160 stepper_y1]                 # 挤出机驱动配置- TMC5160
cs_pin: PF1                          # SPI片选Pin脚定义
spi_software_mosi_pin: PB5
spi_software_miso_pin: PB4
spi_software_sclk_pin: PB3
run_current: 2                    # 电机运行电流值
interpolate: True                  # 是否开启256微步插值（开启是True，关闭是False）
sense_resistor: 0.033               # 驱动采样电阻不要改（如果使用5160 Pro，请将数值修改为0.033）
stealthchop_threshold: 0          # 静音阀值（如果不需要静音，请将数值改为0）

#####################################################################
#                     Z轴步进电机 （Z Stepper Settings）              #
#####################################################################
#  Z1-------------Z2
#   |              |
#   |              |
#   |              |
#  Z----显示屏----Z3

#####################################################################
#                           Z轴步进电机                              #
#####################################################################
##    Z步进电机 - 左前方 on Driver7
[stepper_z]
step_pin: PE2                # z轴电机脉冲引脚设置
dir_pin:  PC5                # z轴电机方向引脚设置,方向引脚需要按实际判断，加感叹号会让运行方向反转
enable_pin: !PF11              # z轴电机使能引脚设置,使能引脚需要加感叹号，否者电机不工作
rotation_distance: 5         # 主动轮周长mm （2GT-20T为 40mm  16T为 32mm）
gear_ratio: 40:20             # 减速比
full_steps_per_rotation: 200  # 电机单圈所需脉冲数（1.8度电机:200，0.9度电机:400
microsteps: 16                # 电机细分设置,细分越高，质量越高，但主控负荷越大
#endstop_pin: PG10            # 限位开关PIN脚,建议常闭然后添加！反转状态,位置在io-2
endstop_pin:probe:z_virtual_endstop
## position_endstop 是喷嘴相对于打印表面(Z0)到Z限位停止触发点的位置(单位:mm)
## 正数值 = 高于平台的终止点，负数值 = 低于平台的的终止点
## 增加position_ endstop的数值会使喷嘴更靠近床
## 在运行Z_ENDSTOP_CALIBRATE之后，position_endstop将存储在CFG配置的最后
#position_endstop:0
position_min: -15             # （配置喷嘴清洁需要-5左右）
position_max: 600             # 机械限位最大行程 (250mm-300mm-350mm)
homing_positive_dir:false
homing_speed: 5               # 复位速度-最大 20
second_homing_speed: 3        # 二次复位速度-最大 10
homing_retract_dist: 2        # 后撤距离
step_pulse_duration: 0.000004

#--------------------------------------------------------------------
[tmc5160 stepper_z]                 # 挤出机驱动配置- TMC5160
cs_pin: PC4                         # SPI 片选Pin脚定义
spi_software_mosi_pin: PB5
spi_software_miso_pin: PB4
spi_software_sclk_pin: PB3
run_current: 2                    # 电机运行电流值
hold_current:1.0
interpolate: True                  # 是否开启256微步插值（开启是True，关闭是False）
sense_resistor: 0.033               # 驱动采样电阻不要改（如果使用5160 Pro，请将数值修改为0.033）
stealthchop_threshold: 0          # 静音阀值（如果不需要静音，请将数值改为0）
#--------------------------------------------------------------------

##    Z1 步进电机 - 后方 on Driver6
[stepper_z1]
step_pin: PE3                # z1轴电机脉冲引脚设置
dir_pin:  PF13              # z1轴电机方向引脚设置,方向引脚需要按实际判断，加感叹号会让运行方向反转
enable_pin: !PF14              # z1轴电机使能引脚设置,使能引脚需要加感叹号，否者电机不工作
rotation_distance: 5         # 主动轮周长mm （2GT-20T为 40mm  16T为 32mm）
gear_ratio: 40:20             # 减速比
full_steps_per_rotation: 200  # 电机单圈所需脉冲数（1.8度电机:200，0.9度电机:400
microsteps: 16                # 电机细分设置,细分越高，质量越高，但主控负荷越大
step_pulse_duration: 0.000004
#--------------------------------------------------------------------
#[tmc2209 stepper_z1]
#uart_pin: PE10                # 驱动通信端口
#interpolate: false            # 微步插值256
#run_current: 0.8              # 运行电流mA
#sense_resistor: 0.110         # 驱动采样电阻不要改
#stealthchop_threshold: 500    # 静音阀值（如果不需要静音，请将数值改为0）
#--------------------------------------------------------------------
[tmc5160 stepper_z1]                # 挤出机驱动配置- TMC5160
cs_pin: PF12                        # SPI 片选Pin脚定义
spi_software_mosi_pin: PB5
spi_software_miso_pin: PB4
spi_software_sclk_pin: PB3
run_current: 2                    # 电机运行电流值
hold_current:1.0
interpolate: True                  # 是否开启256微步插值（开启是True，关闭是False）
sense_resistor: 0.033               # 驱动采样电阻不要改（如果使用5160 Pro，请将数值修改为0.033）
stealthchop_threshold: 0          # 静音阀值（如果不需要静音，请将数值改为0）
#--------------------------------------------------------------------

##    Z2 步进电机 - 右后方 on Driver5
[stepper_z2]
step_pin: PE4                 # z2轴电机脉冲引脚设置
dir_pin: PG0                 # z2轴电机方向引脚设置,方向引脚需要按实际判断，加感叹号会让运行方向反转
enable_pin: !PG1             # z2轴电机使能引脚设置,使能引脚需要加感叹号，否者电机不工作
rotation_distance: 5         # 主动轮周长mm （2GT-20T为 40mm  16T为 32mm）
gear_ratio: 40:20             # 减速比
full_steps_per_rotation: 200  # 电机单圈所需脉冲数（1.8度电机:200，0.9度电机:400
microsteps: 16                # 电机细分设置,细分越高，质量越高，但主控负荷越大
step_pulse_duration: 0.000004
#--------------------------------------------------------------------
#[tmc2209 stepper_z2]
#uart_pin: PF1                 # 驱动通信端口
#interpolate: false            # 微步插值256
#run_current: 0.8              # 运行电流mA
#sense_resistor: 0.110         # 驱动采样电阻不要改
#stealthchop_threshold: 500    # 静音阀值（如果不需要静音，请将数值改为0）
#--------------------------------------------------------------------
[tmc5160 stepper_z2]                # 挤出机驱动配置- TMC5160
cs_pin: PF15                         # SPI 片选Pin脚定义
spi_software_mosi_pin: PB5
spi_software_miso_pin: PB4
spi_software_sclk_pin: PB3
run_current: 2                    # 电机运行电流值
hold_current:1.0
interpolate: True                  # 是否开启256微步插值（开启是True，关闭是False）
sense_resistor: 0.033               # 驱动采样电阻不要改（如果使用5160 Pro，请将数值修改为0.033）
stealthchop_threshold: 0          # 静音阀值（如果不需要静音，请将数值改为0）
#--------------------------------------------------------------------

##    Z3 步进电机 - 右前方 on Driver4
[stepper_z3]
step_pin: PE14                 # z2轴电机脉冲引脚设置
dir_pin: PE8                 # z2轴电机方向引脚设置,方向引脚需要按实际判断，加感叹号会让运行方向反转
enable_pin: !PE9              # z2轴电机使能引脚设置,使能引脚需要加感叹号，否者电机不工作
rotation_distance: 5         # 主动轮周长mm （2GT-20T为 40mm  16T为 32mm）
gear_ratio: 40:20             # 减速比
full_steps_per_rotation: 200  # 电机单圈所需脉冲数（1.8度电机:200，0.9度电机:400
microsteps: 16                # 电机细分设置,细分越高，质量越高，但主控负荷越大
step_pulse_duration: 0.000004
#--------------------------------------------------------------------
#[tmc2209 stepper_z3]
#uart_pin: PG2                 # 驱动通信端口
#interpolate: false            # 微步插值256
#run_current: 0.8              # 运行电流mA
#sense_resistor: 0.110         # 驱动采样电阻不要改
#stealthchop_threshold: 500    # 静音阀值（如果不需要静音，请将数值改为0）
#--------------------------------------------------------------------
[tmc5160 stepper_z3]                # 挤出机驱动配置- TMC5160
cs_pin: PE7                        # SPI 片选Pin脚定义
spi_software_mosi_pin: PB5
spi_software_miso_pin: PB4
spi_software_sclk_pin: PB3
run_current: 2                    # 电机运行电流值
hold_current:1.0
interpolate: True                  # 是否开启256微步插值（开启是True，关闭是False）
sense_resistor: 0.033               # 驱动采样电阻不要改（如果使用5160 Pro，请将数值修改为0.033）
stealthchop_threshold: 0          # 静音阀值（如果不需要静音，请将数值改为0）

#####################################################################
#                     E0 挤出机设置 （E0 Settings）                   # 
#####################################################################
#Driver2
[extruder]                          # 挤出机
step_pin: PE15                       # 挤出电机方脉冲引脚
dir_pin: PE11                       # 挤出电机方向引脚设置
enable_pin: !PF2                    # 挤出电机方使能引脚设置
## 执行挤出机校准时，更新以下值
## 比如你要求100毫米的进料，但实际上是102：
## rotation_distance = <旧rotation_distance> * <实际挤出长度> / <请求的挤出长度>
## 校准步进值: 22.44=旧值22*实际值102/目标值100
rotation_distance: 23.2            # 步进值
gear_ratio: 60:20                   # 减速比（伽利略齿比7.5:1 并且这行注释掉；BMG为50：17，输出轴在前，输入轴在后）
microsteps: 16                      # 电机细分设置,细分越高，质量越高，但主控负荷越大
full_steps_per_rotation: 400        # 单圈脉冲数 （200 为 1.8 度, 400 为 0.9 度）
nozzle_diameter: 0.800              # 喷嘴直径
filament_diameter: 1.75             # 耗材直径
heater_pin: multi_pin:heaters                     # 加热棒引脚
sensor_type: PT1000          # 传感器型号  (Generic 3950, ATC Semitec 104GT-2， PT1000)
sensor_pin: PF4                     # 传感器引脚,连接到 ADC_0   
min_temp: -10                        # 最小温度（注意：测量温度超过设定值会触发紧急停止）
max_temp: 300                       # 最大温度（注意：测量温度超过设定值会触发紧急停止）
max_power: 1.0                      # 最大功率
min_extrude_temp: 170               # 最小挤出温度（至少需要达到这个温度，挤出机才能挤出）
pressure_advance: 0.05              # 推进压力-尽量将压力保持在1.0以下(压力提前是调整这个)
#压力提前调整方法:https://www.klipper3d.org/zh/Pressure_Advance.html
pressure_advance_smooth_time: 0.040 # 平稳推进时间-默认值为0.040
#max_extrude_only_distance: 200.0   # 挤出流量报错可以注释这个，但是建议重新切片
#喷嘴温度PID校准命令：  "PID_CALIBRATE HEATER=extruder TARGET=245
#control = pid                # PID喷嘴温度自动校准项（pid校准完成后，会被注释）
#pid_kp = 26.213              # PID喷嘴温度自动校准项（pid校准完成后，会被注释）
#pid_ki = 1.304               # PID喷嘴温度自动校准项（pid校准完成后，会被注释）
#pid_kd = 131.721             # PID喷嘴温度自动校准项（pid校准完成后，会被注释）
step_pulse_duration: 0.000004

[multi_pin heaters]
pins: PB0,PB1
#--------------------------------------------------------------------
[tmc2209 extruder]                  # 挤出机驱动配置- TMC2209
uart_pin: PE10                      # 通讯端口Pin脚定义
interpolate: True                  # 是否开启256微步插值（开启是True，关闭是False）
run_current: 0.8                    # 电机运行电流值
sense_resistor: 0.110               # 驱动采样电阻不要改
stealthchop_threshold: 0          # 静音阀值（如果不需要静音，请将数值改为0）
#--------------------------------------------------------------------
#[tmc5160 extruder]                  # 挤出机驱动配置- TMC5160
#cs_pin: PF15                        # SPI 片选Pin脚定义
# spi_software_mosi_pin: PB5
# spi_software_miso_pin: PB4
# spi_software_sclk_pin: PB3
#run_current: 1.0                    # 电机运行电流值
#interpolate: False                  # 是否开启256微步插值（开启是True，关闭是False）
#sense_resistor: 0.075               # 驱动采样电阻不要改（如果使用5160 Pro，请将数值修改为0.033）
#stealthchop_threshold: 500          # 静音阀值（如果不需要静音，请将数值改为0）

#####################################################################
#                            热床配置                                # 
#####################################################################
[heater_bed]
heater_pin: PE5              # 热床接口
sensor_type: Generic 3950    # 热床传感器类型
sensor_pin:  PC1             # 热床传感器接口
max_power: 1.0               # 热床功率
min_temp: 0                  # 最小温度（注意：测量温度超过设定值会触发紧急停止）
max_temp: 490                # 最大温度（注意：测量温度超过设定值会触发紧急停止）
# 热床温度PID校准命令：  "PID_CALIBRATE HEATER=heater_bed TARGET=100"
#control: pid                # PID热床温度自动校准项（pid校准完成后，会被注释）
#pid_kp: 58.437              # PID热床温度自动校准项（pid校准完成后，会被注释）
#pid_ki: 2.347               # PID热床温度自动校准项（pid校准完成后，会被注释）
#pid_kd: 363.769             # PID热床温度自动校准项（pid校准完成后，会被注释）
#####################################################################
#                            风扇配置                                # 
#####################################################################
#[fan]                        # 模型冷却风扇
#pin: PA0                     # 信号接口
#kick_start_time: 0.5         # 启动时间（勿动）
#off_below: 0.10              # 勿动
#--------------------------------------------------------------------
# 以[fan_generic]替代 模型冷却风扇[fan]
# 默认模型冷却风扇
[fan_generic fan0]
pin: PA2
cycle_time: 0.01
hardware_pwm: false

[multi_pin auxiliary-fans]
pins: PA15,PB11

# 辅助模型冷却风扇
# 若无辅助风扇请禁用
[fan_generic fan2]
pin: multi_pin:auxiliary-fans
cycle_time: 0.01
hardware_pwm: false

[gcode_macro M106]
gcode:
    {% set fan = 'fan' + (params.P|int if params.P is defined else 0)|string %}
    {% set speed = (params.S|float / 255 if params.S is defined else 1.0) %}
    SET_FAN_SPEED FAN={fan} SPEED={speed}


#--------------------------------------------------------------------   
[heater_fan hotend_fan]      # 喉管冷却风扇
pin: PA0                     # 信号接口
max_power: 1.0               # 最大转速
kick_start_time: 0.5         # 启动时间（勿动）
heater: extruder             # 关联的设备：挤出机
heater_temp: 50              # 挤出机达到多少度启动风扇
fan_speed: 1.0               # 风扇转速
#--------------------------------------------------------------------
#[heater_fan controller_fan]  # 电器仓风扇
#pin: PA2                     # 信号接口
#max_power: 1.0               # 最大转速
#kick_start_time: 0.5         # 启动时间（勿动）
#heater: heater_bed           # 关联的设备：热床
#heater_temp: 50              # 热床达到多少度启动风扇
#fan_speed: 1.0               # 风扇转速
#--------------------------------------------------------------------
#[heater_fan exhaust_fan]     # 排风扇风扇
#pin: PF6                     # 信号接口
#max_power: 1.0               # 最大转速
#shutdown_speed: 0
#kick_start_time: 0.5         # 启动时间（勿动）
#heater: extruder           # 关联的设备：热床
#heater_temp: 50              # 热床达到多少度启动风扇
#fan_speed: 1.0               # 风扇转速
#off_below: 0.10
#--------------------------------------------------------------------
#[temperature_fan mcut]    # 温控风扇
#pin: PA3
#kick_start_time: 0.500
#sensor_type: temperature_host
#control: watermark
# 高于以下温度启用风扇
#target_temp: 55.0
# 允许的温度范围
#min_temp: 0
#max_temp: 90
# 调节最大风速以降低噪音
#max_speed: 1.0
#min_speed: 0.3

#####################################################################
#                           调平传感器                               #
#####################################################################
#默认PL08N感应探头不低于喷嘴高度，仅用于调平,如果你的PL08N是NO（常开），请将更改pin添加到！
[probe]
pin:^PG9
x_offset: 30                  # X轴-传感器相对喷嘴偏移量
y_offset: 35                  # Y轴-传感器相对喷嘴偏移量
#z_offset: 0                  # Z轴-传感器相对喷嘴偏移量
speed: 3                     # 调平速度
samples: 3                   # 采样次数
samples_result: median       # 取值方式（默认median-中位数）
sample_retract_dist: 4.0     # 调平回缩距离
samples_tolerance: 0.02      # 采样公差（注意过小的值可能造成采样次数增加）
samples_tolerance_retries: 3 # 超公差重试次数

#####################################################################
#                               归位                                #
#####################################################################
#[safe_z_home]                # Z轴限位坐标
#home_xy_position:20,550     # Z轴限位位置定义（重要！！！自行进行调整）
#speed:100                     # 归位速度
#z_hop:10                     # 归位之前抬升高度
#--------------------------------------------------------------------
#[homing_override]
#axes: z
#set_position_z: 0
#gcode:
#   G90
#   G0 Z15 F600
#   G28 X Y
#    ## Z 限位开关的 XY 位置
#    ##通过后将X0和Y0更新为你的值（如X157、Y305）
#    ## Z 轴限位位置定义
#   G0 X185 Y250 F3600    #250mm   
#   G28 Z
#   G0 Z10 F1800

#####################################################################
#                           4Z调平 
#####################################################################
[quad_gantry_level]          # 600mm机器调平参数
gantry_corners:
    -105,75
    705,675
points:                      # 600mm机器调平点位
 20,20
 20,550
 550,550
 550,20
#--------------------------------------------------------------------

speed: 100                   # 调平速度
horizontal_move_z: 10        # Z轴起始高度
retry_tolerance: 0.05      # 采样公差
retries: 5                   # 超公差重试次数
max_adjust: 10               # 调平最大调整行程

#####################################################################
#                      FLY-Mini 12864 LCD
#####################################################################
[board_pins]
aliases:
    EXP1_1=PE12, EXP1_3=PB2,  EXP1_5=PC14,   EXP1_7=PG14,  EXP1_9=<GND>,
    EXP1_2=PE13, EXP1_4=PG8,  EXP1_6=PC13,   EXP1_8=PG13,  EXP1_10=<5V>,
    # EXP2 header
    EXP2_1=PA6, EXP2_3=PB7,  EXP2_5=PB6,  EXP2_7=PG15,   EXP2_9=<GND>,
    EXP2_2=PA5, EXP2_4=PA4,  EXP2_6=PA7,  EXP2_8=<RST>,  EXP2_10=<NC>,
#--------------------------------------------------------------------    

#####################################################################
#                          闲置关闭热床
#####################################################################
[idle_timeout]
timeout: 1800                # 空闲时间超过30分钟则关闭热床

#####################################################################
#                           自定义gcode宏                            #
#####################################################################
[gcode_arcs]                       # 允许圆弧插补
resolution: 1.0                    # 启用圆弧插补G2，G3
#   一条弧线将被分割成若干段。每段的长度将
#   等于上面设置的分辨率（mm）。更低的值会产生一个
#   更细腻的弧线，但也会需要机器进行更多运算。小于
#   配置值的曲线会被视为直线。
#   默认为1毫米。

#--------------------------------------------------------------------
[gcode_macro PRINT_START]          # 将 PRINT_START 设置为开始打印时的宏，自定义打印前的动作
gcode:
    G92 E0                         # 重置挤出
    BED_MESH_CLEAR                 # 卸载网床
    G28                            # 归位所有轴
    quad_gantry_level              # 龙门架调平
    G28                            # 归位所有轴
    G1 Z20 F3000                   # 将喷嘴移离热床
    BED_MESH_PROFILE LOAD=default  # 加载网床
#--------------------------------------------------------------------
[gcode_macro PRINT_HUAXIAN]        # 将 PRINT_HUAXIAN] 设置为PRINT_START后的宏，自定义打印前的动作
gcode:
    G1 Z5 F3000 
    G92 E0;              # 重置挤出
    G90                  # 设置绝对坐标体系
    G0 X5 Y1 F6000       # 移动至x5 y1位置，速度100mm/s（F6000，意思为6000mm每分钟）
    G0 Z0.4              # 移动z轴高度至0.4
    G91                  # 设置坐标体系为相对坐标
    G1 X100 E20 F1200;   # 移动x轴100mm，并挤出，更改F可更改挤出率
    G1 Y1                # 移动y轴1mm
    G1 X-100 E20 F1200;  # 反方向移动x轴100mm，并挤出，更改F可更改挤出率
    G0 z5                # 抬高z轴5mm
    G1 E-5.0 F3600       # 缩回耗材丝
    G92 E0;              # 重置挤出
    G90                  # 设置绝对坐标体系 
#--------------------------------------------------------------------
[gcode_macro M190]
rename_existing: M190.1
gcode:
    #Parameters
    {% set s = params.S|float %}
    M140 {% for p in params %}{'%s%s' % (p, params[p])}{% endfor %}  ; Set hotend temp
    {% if s != 0 %}
    TEMPERATURE_WAIT SENSOR=heater_bed MINIMUM={s} MAXIMUM={s+3}   ; Wait for hotend temp (within 1 degree)
    {% endif %}	
#--------------------------------------------------------------------
[gcode_macro PRINT_END]            # 将 PRINT_END 设置为打印结束时的宏，自定义打印完成之后动作
gcode:
    #   Get Boundaries
    {% set max_x = printer.configfile.config["stepper_x"]["position_max"]|float %}
    {% set max_y = printer.configfile.config["stepper_y"]["position_max"]|float %}
    {% set max_z = printer.configfile.config["stepper_z"]["position_max"]|float %}
    
    #   Check end position to determine safe directions to move
    {% if printer.toolhead.position.x < (max_x - 20) %}
        {% set x_safe = 20.0 %}
    {% else %}
        {% set x_safe = -20.0 %}
    {% endif %}

    {% if printer.toolhead.position.y < (max_y - 20) %}
        {% set y_safe = 20.0 %}
    {% else %}
        {% set y_safe = -20.0 %}
    {% endif %}

    {% if printer.toolhead.position.z < (max_z - 2) %}
        {% set z_safe = 2.0 %}
    {% else %}
        {% set z_safe = max_z - printer.toolhead.position.z %}
    {% endif %}
 
    M400                              # 等待缓冲区清除
    G92 E0                            # 将挤出机归零
    G1 E-10.0 F3600                   # 缩回耗材丝
    G91                               # 相对定位
    G0 Z{z_safe} F3600                # 抬高龙门
    G0 X{x_safe} Y{y_safe} F20000     # 移动喷嘴以移除架线
    M104 S0                           # 关闭挤出头
    M140 S0                           # 关闭热床
    M106 S0                           # 关闭模型风扇
    SET_FAN_SPEED FAN=fan2 SPEED=0    # 关闭辅助风扇
    G90                               # 设置绝对坐标体系
    G0 X{max_x / 2} Y{max_y} F3600    # 将喷嘴停在后部
    BED_MESH_CLEAR                    # 卸载网床

#*# <---------------------- SAVE_CONFIG ---------------------->
#*# DO NOT EDIT THIS BLOCK OR BELOW. The contents are auto-generated.
#*#
#*# [bed_mesh default]
#*# version = 1
#*# points =
#*# 	0.569621, 0.270402, 0.116496, 0.076652, 0.146183, 0.431339
#*# 	0.670402, 0.357902, 0.178996, 0.132121, 0.218839, 0.524308
#*# 	0.646183, 0.334464, 0.156339, 0.121183, 0.225871, 0.537589
#*# 	0.568058, 0.244621, 0.055558, 0.024308, 0.143839, 0.457121
#*# 	0.536027, 0.208683, 0.025871, 0.001652, 0.121964, 0.443839
#*# 	0.621964, 0.253214, 0.050089, 0.004777, 0.132121, 0.464152
#*# x_count = 6
#*# y_count = 6
#*# mesh_x_pps = 2
#*# mesh_y_pps = 2
#*# algo = bicubic
#*# tension = 0.2
#*# min_x = 50.0
#*# max_x = 550.0
#*# min_y = 50.0
#*# max_y = 550.0
#*#
#*# [extruder]
#*# control = pid
#*# pid_kp = 24.516
#*# pid_ki = 1.308
#*# pid_kd = 114.919
#*#
#*# [heater_bed]
#*# control = pid
#*# pid_kp = 52.468
#*# pid_ki = 0.272
#*# pid_kd = 2528.290
#*#
#*# [probe]
#*# z_offset = 3.300
